iandchasse/silkscreen-light-attachment/design/visor-reflector-study.md

# Visor reflector study (2026-10-20)

Model: `tools/visor_reflector_sim.py` (geometry only; Lambertian 120 deg LEDs at y 115.9 / z 9.5, both strings lit). Mirror = specular strip on the visor inner face, R 0.85 (aluminium / mirror tape); white print = Lambertian R 0.80. "flare" = the visor face leans outward (bottom edge further from the case), like a lampshade. Numbers are page light relative to today's mid-page.

```

=== PLAIN page (z 3.926); numbers are page light relative to TODAY's mid-page ===
case                                       d2    d10    d20    mid    d70    bot | top2-20 btmhalf top/btm
bare LEDs (today)                        0.00  12.18   4.90   1.00   0.38   0.19 |   11.60    0.46    25.4
mirror R0.85 to y113.0 tilt 0           26.49  12.18   4.90   1.00   0.38   0.19 |   17.70    0.46    38.8
mirror R0.85 to y113.0 tilt 10          18.51  12.18   4.90   1.00   0.38   0.19 |   11.60    0.46    25.4
mirror R0.85 to y113.0 tilt 20           0.00  12.18   4.90   1.00   0.38   0.19 |   11.60    0.46    25.4
mirror R0.85 to y111.0 tilt 0           26.49  25.81   4.90   1.00   0.38   0.19 |   24.30    0.46    53.2
mirror R0.85 to y111.0 tilt 10          35.33  12.18   4.90   1.00   0.38   0.19 |   20.43    0.46    44.7
mirror R0.85 to y111.0 tilt 20          40.33  12.18   4.90   1.00   0.38   0.19 |   15.57    0.46    34.1
mirror R0.85 to y109.5 tilt 0           26.49  25.81  11.06   1.00   0.38   0.19 |   25.45    0.46    55.7
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
