iandchasse/silkscreen-light-attachment/pcb/docs/design_summary.md

# As-built design summary (generated by tools/report_design.py; do not edit)

Project silkscreen-light-attachment rev B, 2026-09-25. Frames: KiCad K (x_K = X + 100, y_K = 100 - Z) and enclosure E (X, Z; Y up the device). All parts on F.Cu (faces -Y, toward the case).

Board outline bbox (K): x 97.475..162.525, y 88.975..106.025; thickness 1.000 mm; 2 copper layers.

## String voltage sanity

- N = 5 LEDs per string, Rs = 200 R (CRCW0805200RFKEAHP), no series diode (rev B).
- N x Vf at 13.3 mA: 13.00 / 14.25 / 15.75 V (min / typ / max, 25 C); 16.27 V max at -10 C.
- Rs drop 2.66 V at 13.3 mA (2.79 V at 13.96 mA); Rs dissipation 39 mW.
- LED_SW (V_OUT, incl. R37 sense + FET; no diode): 16.01 V min hot, 17.26 V typ, **19.41 V worst (cold, max bin)** vs the 22.0 V ceiling (margin 2.59 V) and OVP min 24.25 V (margin 4.84 V).
- Hold-off at ~14 uA hot: 11.5 V > 6.5 V (boost body-diode rule).
- LED_MONIT lit 1.71..2.08 V; open 2.60..2.73 V (separated).
- Hot-plug peak (C9 at OVP, loop 243.5 R incl. Rs 200 R; typ..min LED bin): TPS923610 (25.5 V) 47.0-52.6 mA, TPS923611 (31.4 V) 71.3-76.8 mA, both < IFP 80 mA (IFP is rated at 0.1 ms, 1/10 duty; this pulse lasts ~0.25-1 ms, so the margin is an estimate) (gate). TPS923611 LED_SW-to-GND misinsertion ~83 mA until the OVP latch. Rs peak power in the worst pulse 1.18 W for ~1 ms (pulse-proof CRCW-HP 0805).
- Verdict: PASS.

## Parts and sourcing

- Rs choice: CRCW0805200RFKEAHP (LCSC C5972814, JLC Extended): pulse-proof 0805, kept from rev A; no JLC Basic 200 R with a documented ~1 W / 1 ms pulse rating was substituted (checked 2026-09-25 (JLC parts API, JLC Extended)). DigiKey 541-CRCW0805200RFKEAHPCT-ND (DigiKey search page for the MPN, 2026-09-25).
- J1 Hong Cheng HC-PZ254-11.5L-1x2PZ (LCSC C27985187, JLC Extended (no Basic 2.54 mm headers are listed; checked 2026-09-25); stock 24852 on 2026-09-25), pads J6 5/6: **hand-soldered by the builder**, in bom.csv, not in jlc_bom.csv / jlc_cpl.csv (12 SMT parts). DigiKey alternative: Harwin M20-9990246 (DigiKey product 3728226) - 6.1 mm post.
- J2 Hong Cheng HC-PZ254-11.5L-1x1PZ (LCSC C27985186, JLC Extended (no Basic 2.54 mm headers are listed; checked 2026-09-25); stock 10775 on 2026-09-25), pads J6 11: **hand-soldered by the builder**, in bom.csv, not in jlc_bom.csv / jlc_cpl.csv (12 SMT parts). DigiKey alternative: 1 pin cut from Harwin M20-9990246 (DigiKey product 3728226).
- Header numbers: body 2.5 / post 6.0 / tail 3.0 / pin 0.64 sq. Source: LCSC/JLC product attributes 2026-09-25 (insulation height 2.5 mm, mating pin 6 mm, end pin 3 mm, square pin, brass, gold); total 11.5 mm from the MPN; 0.64 mm square pin assumed (not listed). Alternative: Harwin M20-9990246 (DigiKey product 3728226): 1x2, 3 mm tail, 6.1 mm mating (tin); 0.1 mm deeper.
- Post tips at Y 108.10 (underside 116.60 - body 2.5 - post 6.0); J6 face Y 112.82..113.15 -> engagement 4.72..5.05 mm (limits 3.7..6.0). Tails end at Y 119.60 (2.00 above the PCB top).
- LEDs: MPN shared by every CCT; warm = C210340 (3000 K), cool = C210343 (6000 K). DigiKey: n/a - LCSC only (C210340 warm / C210343 cool).
- CPL rotation offsets (EasyEDA footprints, docs/sources/ee_*.json): LED C210340 +0 (pad 1 at -x in both), R 0805 +0 (non-polar). See docs/jlc-notes.md.

## Deviations / notes (DESIGN-SPEC-revB)

- STEP frame: kicad-cli 9.0.6 writes the bare dielectric slab (0.91) at z_s 0..0.91 and seats F-side models on the component plane z_F (~0.995). make_outputs calibrates z_F on the J1 body box and maps Y = 116.60 - (z_s - z_F), X = x_s - 100, Z = 100 + y_s (+90 deg about X, det +1). Header tips are asserted at the geometry.json values; the slab in the E-frame STEP is ~0.09 thinner than 1.0 (copper + mask not modelled). Use build/geometry.json for fit.
- LED silk cathode mark = two short bars along the long sides over pad 1 (a bar across the end would sit in the 0.43 gap of a warm/cool pair). LED courtyard = pads + 0.195 so the 3.8 mm pair pitch leaves 0.04.
- Header courtyards = the modelled bodies (2.50 wide per row), so J1 and J2 sit 0.04 apart; the F-side silk is one L-shaped outline around both bodies drawn on the board, not in the footprints.
- Part keep-outs (case top except the J6 opening, LED band, R zone, boss holes +0.4) are enforced by tools/check_handedness.py (courtyard boxes), not by KiCad rule areas.
- Header pin section 0.64 square and body width 2.50 are assumed (standard for the HC-PZ254 style; the LCSC page lists body 2.5 / post 6 / tail 3 but no drawing numbers were readable).
- Fab outputs (Gerber X2 dates, STEP, PDFs) carry timestamps; the generated KiCad sources are deterministic.

## Footprints

| Ref | Value | Footprint | x_K | y_K | rot | X (E) | Z (E) | pads (num: net) |
|---|---|---|---|---|---|---|---|---|
| D1 | HL-A-3014H421W-S1-08HL-HR3 | LED_3014_HONGLI_HL-A-3014H421W | 101.100 | 90.500 | 180 | 1.100 | 9.500 | 1: /W_K1, 2: /LED_SW |
| D2 | HL-A-3014H421W-S1-08HL-HR3 | LED_3014_HONGLI_HL-A-3014H421W | 114.600 | 90.500 | 180 | 14.600 | 9.500 | 1: /W_K2, 2: /W_K1 |
| D3 | HL-A-3014H421W-S1-08HL-HR3 | LED_3014_HONGLI_HL-A-3014H421W | 128.100 | 90.500 | 180 | 28.100 | 9.500 | 1: /W_K3, 2: /W_K2 |
| D4 | HL-A-3014H421W-S1-08HL-HR3 | LED_3014_HONGLI_HL-A-3014H421W | 141.600 | 90.500 | 180 | 41.600 | 9.500 | 1: /W_K4, 2: /W_K3 |
| D5 | HL-A-3014H421W-S1-08HL-HR3 | LED_3014_HONGLI_HL-A-3014H421W | 155.100 | 90.500 | 180 | 55.100 | 9.500 | 1: /W_R, 2: /W_K4 |
| D6 | HL-A-3014H421W-S1-08HL-HR3 | LED_3014_HONGLI_HL-A-3014H421W | 104.900 | 90.500 | 180 | 4.900 | 9.500 | 1: /C_K1, 2: /LED_SW |
| D7 | HL-A-3014H421W-S1-08HL-HR3 | LED_3014_HONGLI_HL-A-3014H421W | 118.400 | 90.500 | 180 | 18.400 | 9.500 | 1: /C_K2, 2: /C_K1 |
| D8 | HL-A-3014H421W-S1-08HL-HR3 | LED_3014_HONGLI_HL-A-3014H421W | 131.900 | 90.500 | 180 | 31.900 | 9.500 | 1: /C_K3, 2: /C_K2 |
| D9 | HL-A-3014H421W-S1-08HL-HR3 | LED_3014_HONGLI_HL-A-3014H421W | 145.400 | 90.500 | 180 | 45.400 | 9.500 | 1: /C_K4, 2: /C_K3 |
| D10 | HL-A-3014H421W-S1-08HL-HR3 | LED_3014_HONGLI_HL-A-3014H421W | 158.900 | 90.500 | 180 | 58.900 | 9.500 | 1: /C_R, 2: /C_K4 |
| H1 | M1 housing boss (dia 4.40) + ST2.2 screw | NPTH_4.80mm | 110.000 | 101.000 | 0 | 10.000 | -1.000 | npth: - |
| H2 | M2 housing boss (dia 4.40) + ST2.2 screw | NPTH_4.80mm | 138.000 | 101.000 | 0 | 38.000 | -1.000 | npth: - |
| J1 | HC-PZ254-11.5L-1x2PZ | J6_PLUG_1x2_P5_P6 | 155.932 | 103.810 | 0 | 55.932 | -3.810 | 5: /LED_SW, 6: /W- |
| J2 | HC-PZ254-11.5L-1x1PZ | J6_PLUG_1x1_P11 | 154.662 | 101.270 | 0 | 54.662 | -1.270 | 11: /C- |
| R1 | CRCW0805200RFKEAHP | R_0805_2012Metric | 145.500 | 103.600 | 0 | 45.500 | -3.600 | 1: /W_R, 2: /W- |
| R2 | CRCW0805200RFKEAHP | R_0805_2012Metric | 149.000 | 101.400 | 0 | 49.000 | -1.400 | 1: /C_R, 2: /C- |

## Copper by net

| Net | F.Cu mm | B.Cu mm | widths | vias |
|---|---|---|---|---|
| /C- | 4.8 | 0.0 | [0.4] | [] |
| /C_K1 | 13.2 | 0.0 | [0.25] | [] |
| /C_K2 | 13.2 | 0.0 | [0.25] | [] |
| /C_K3 | 13.2 | 0.0 | [0.25] | [] |
| /C_K4 | 13.2 | 0.0 | [0.25] | [] |
| /C_R | 21.8 | 0.0 | [0.4] | [] |
| /LED_SW | 7.5 | 64.3 | [0.25, 0.4] | [(99.87, 92.6)] |
| /W- | 13.5 | 0.0 | [0.4] | [] |
| /W_K1 | 13.8 | 0.0 | [0.25] | [] |
| /W_K2 | 13.8 | 0.0 | [0.25] | [] |
| /W_K3 | 13.8 | 0.0 | [0.25] | [] |
| /W_K4 | 13.8 | 0.0 | [0.25] | [] |
| /W_R | 23.7 | 0.0 | [0.4] | [] |

## Handedness / placement gate (tools/check_handedness.py)

- PASS exactly 3 plated through-holes, all on J1/J2 (found 3)
- PASS pad '5' on J1 (want J1)
- PASS J1 '5' at E (54.662, -3.810) vs J6-5 (54.662, -3.810): 0.0000 <= 0.02
- PASS J1 '5' via the STEP chain: E (54.662, Y 116.60, -3.810) agrees
- PASS J1 '5' net LED_SW == J6-5 LED_SW
- PASS pad '6' on J1 (want J1)
- PASS J1 '6' at E (57.202, -3.810) vs J6-6 (57.202, -3.810): 0.0000 <= 0.02
- PASS J1 '6' via the STEP chain: E (57.202, Y 116.60, -3.810) agrees
- PASS J1 '6' net W- == J6-6 W-
- PASS pad '11' on J2 (want J2)
- PASS J2 '11' at E (54.662, -1.270) vs J6-11 (54.662, -1.270): 0.0000 <= 0.02
- PASS J2 '11' via the STEP chain: E (54.662, Y 116.60, -1.270) agrees
- PASS J2 '11' net C- == J6-11 C-
- PASS STEP->E rotation determinant 1 (proper rotation)
- PASS J6-12 P+_FUSE at E (57.202, -1.27): nearest copper 1.690, nearest hole 2.030 (>= 1.0)
- PASS J6-4 GND at E (52.122, -3.81): nearest copper 1.390, nearest hole 2.030 (>= 1.0)
- PASS 2 NPTH holes (params: 2)
- PASS NPTH M1 dia 4.8 at E (10.0, -1.0)
- PASS NPTH M2 dia 4.8 at E (38.0, -1.0)
- PASS copper to NPTH edge min 3.965 >= 0.4
- PASS tracks to NPTH edge min 3.988 >= 0.5
- PASS D1 on F.Cu
- PASS D1 courtyard E x -0.78..2.98 z 8.55..10.45: clear of keep-outs
- PASS R1 on F.Cu
- PASS R1 courtyard E x 43.82..47.18 z -4.55..-2.65: clear of keep-outs
- PASS R2 on F.Cu
- PASS R2 courtyard E x 47.32..50.68 z -2.35..-0.45: clear of keep-outs
- PASS D6 on F.Cu
- PASS D6 courtyard E x 3.02..6.78 z 8.55..10.45: clear of keep-outs
- PASS D5 on F.Cu
- PASS D5 courtyard E x 53.22..56.98 z 8.55..10.45: clear of keep-outs
- PASS D4 on F.Cu
- PASS D4 courtyard E x 39.72..43.48 z 8.55..10.45: clear of keep-outs
- PASS D8 on F.Cu
- PASS D8 courtyard E x 30.02..33.78 z 8.55..10.45: clear of keep-outs
- PASS D10 on F.Cu
- PASS D10 courtyard E x 57.02..60.78 z 8.55..10.45: clear of keep-outs
- PASS J1 on F.Cu
- PASS J1 courtyard E x 53.39..58.47 z -5.06..-2.56: clear of keep-outs
- PASS D9 on F.Cu
- PASS D9 courtyard E x 43.52..47.28 z 8.55..10.45: clear of keep-outs
- PASS D2 on F.Cu
- PASS D2 courtyard E x 12.72..16.48 z 8.55..10.45: clear of keep-outs
- PASS J2 on F.Cu
- PASS J2 courtyard E x 53.39..55.93 z -2.52..-0.02: clear of keep-outs
- PASS D7 on F.Cu
- PASS D7 courtyard E x 16.52..20.28 z 8.55..10.45: clear of keep-outs
- PASS D3 on F.Cu
- PASS D3 courtyard E x 26.22..29.98 z 8.55..10.45: clear of keep-outs
- PASS NPTH M1 dia 4.8 at E (10.0, -1.0): web to board edge 2.600 >= 0.5
- PASS NPTH M2 dia 4.8 at E (38.0, -1.0): web to board edge 2.600 >= 0.5
- INFO outline 8 Edge.Cuts primitives; min NPTH web 2.600 (M1)
- PASS silk: 33 strokes, min width 0.150 >= 0.15
- PASS silk: 8 visible texts, min height 1.000, min stroke 0.150; W/C markers at >= 1.0
