iandchasse/silkscreen-light-attachment/design/superseded/README.md

# Superseded

Partial architecture proposals from 2026-09-25 written while the scope still included an in-case (integrated bezel) variant. The runs were stopped when the scope changed to the external clip-on only. Kept for history; do not use.
