iandchasse/silkscreen-light-attachment/design/superseded/proposal-A-one-pcba.md

# Proposal A - one PCBA for both variants (architect)

Status: IN PROGRESS (skeleton written first; sections fill in as the analysis lands). 2026-09-25.

## 0. Decision summary
(pending)

## 1. PCBA
(pending)

## 2. Header safety
(pending)

## 3. External clip-on housing
(pending)

## 4. Integrated variant (modified enclosure copy)
(pending)

## 5. Risks, open questions, build plan
(pending)
