iandchasse/silkscreen-light-attachment/design/superseded/proposal-B-best-light.md

# Proposal B: best light (architect)

Status: IN PROGRESS (skeleton, 2026-09-25). Frame: enclosure frame (X = KiCad X - 44.24, Y = 148.25 - KiCad Y, Z = 0 at
main-PCB rear, +Z toward the viewer).

## 0. Decision summary
(pending)

## 1. PCBA
(pending)

## 2. Header safety
(pending)

## 3. External clip-on housing
(pending)

## 4. Integrated variant
(pending)

## 5. Risks, open questions, build plan
(pending)
