iandchasse/silkscreen-light-attachment/archive/rev-A-rod-lens/housing/out/REPORT.md

# Housing build report (rev A)

Generated by `housing/src/build.py` (deterministic, E frame). PCBA for the fit checks: pcb/build/geometry.json (pcb/tools/export_geometry.py, 2026-09-25); used from file: outline (102 pts), 9 NPTH holes, 15 body boxes, 3 header pins.

| Check | Result | Key numbers |
|---|---|---|
| 1. Seated vs stock case | PASS | back bumps 0.3/0.3, leaf bump 0.4; corner fingers gap 0.096/0.096; boss 0.315 |
| 2. Insertion sweep h 15 -> 0 | PASS | 0 undesigned collisions; X guided from h 7.31, Z from h 10.266, pins touch J6 at h 5.42 |
| 3. Pins vs J6 | PASS | tips [107.94]; E 4.68..5.21; wall clearance 1.165 nominal / 1.115 centred |
| 4. Optics keep-out | PASS | intrusion {'clip': 0.0, 'cover': 0.0, 'carrier': 0.0}; clip gap with float 0.1 |
| 5. PCBA/carrier at float extremes | PASS | carrier/rod min 0.443; PCBA min 0.4 (>= 0.40, designed contacts excluded) |
| 5b. PCB agent's E-frame PCBA STL (cross-check) | OK | y 107.94..121.4; part bodies to clip 0.7, to cover 0.696 (seated nominal) |
| 6. Printability | PASS | overhang patches flagged {'clip': 0, 'cover': 15, 'carrier': 16}, all bridge-width; undeclared min wall {'clip': 1.015, 'cover': 1.0, 'carrier': 1.0} |
| 7. Exports | PASS | 13 files |
| 8. Rod datum (rev A) | PASS | rod axis preloaded y 113.91, z [15.8, 15.8] (target 113.91 / 15.80 +-0.05); LED gap 2.0; lip interference [0.16]; snap chord 3.6 |
| 9. Tongue-bump lead-in (rev A) | PASS | full crest from y [119.55]; bump bottom [-0.35] vs the PCB edge; overlap at landing 0.0 mm3 |
| Screws (rev A) | PASS | ST2.2 x 6.5 pan, plastics thread-forming (DIN 7981 form / PT class); tip 115.9, above the case {'C0': 0.3, 'C1': 0.3, 'C2': 0.3}; engaged {'C0': 2.5, 'C1': 2.5, 'C2': 2.4}; walls {'C2 pilot to the header-notch face x 59.20': 0.8, 'C2 after thread forming (major 2.2)': 0.6, 'C1 pilot in the P3 pad layer (z)': [0.75, 0.85], 'cover column wall': 0.55, 'screw radial clearance in the column bore': 0.15} |

**Overall: PASS**

## Rod datum and retention (check 8, rev A)

```
{
 "rod_axis_preloaded": {
  "y": 113.91,
  "z": [
   15.8,
   15.8
  ]
 },
 "lips": {
  "lip_L_mz": {
   "interference": 0.16,
   "contact_deg_below_equator": 11.3,
   "x": [
    -2.8,
    -1.4
   ]
  },
  "lip_L_pz": {
   "interference": 0.16,
   "contact_deg_below_equator": 11.3,
   "x": [
    -2.8,
    -1.4
   ]
  },
  "lip_R_mz": {
   "interference": 0.16,
   "contact_deg_below_equator": 11.3,
   "x": [
    61.4,
    62.8
   ]
  },
  "lip_R_pz": {
   "interference": 0.16,
   "contact_deg_below_equator": 11.3,
   "x": [
    61.4,
    62.8
   ]
  }
 },
 "led_face_y_min": 117.91,
 "gap_led_to_rod": 2.0,
 "cradle": {
  "bore_d": 4.15,
  "bore_centre_y": 113.835,
  "crown_y": 115.91,
  "rod_axis_on_crown_y": 113.91,
  "lip": {
   "t": 0.8,
   "slot": 0.4,
   "root_deg_above_equator": 56.0,
   "hook_deg_below_equator": [
    4.0,
    12.0
   ],
   "hook_radius_about_axis": 1.84,
   "interference_radial": 0.16,
   "x_length": 1.4,
   "tip_deg": 22.0,
   "tip_chord": 4.1
  },
  "snap_chord_at_hook": 3.6,
  "snap_deflection_each_lip": 0.2,
  "radial_play_at_equator": 0.075,
  "axial_play_each_end": 0.2,
  "end_wall_behind_socket": 1.0,
  "dowel": {
   "d": 1.5,
   "L": 4.0,
   "hole_d": 1.55,
   "hole_depth": 2.4
  },
  "dowel_hole_floor_over_crown": 0.3
 }
}
```

## Engagement order (as built, h above seated)

| h | event |
|---|---|
| 10.266 | back_finger_R engages (gap <= 0.2) |
| 10.265 | back_finger_L engages (gap <= 0.2) |
| 9.63 | corner_finger_L.front(Z) engages (gap <= 0.15) |
| 9.63 | corner_finger_R.front(Z) engages (gap <= 0.15) |
| 8.726 | clip.back_bump_R starts riding the case (preload builds) |
| 8.725 | clip.back_bump_L starts riding the case (preload builds) |
| 8.213 | clip.back_bump_L reaches full preload (on the flat face) |
| 8.213 | clip.back_bump_R reaches full preload (on the flat face) |
| 8.099 | clip.leaf_bump starts riding the case (preload builds) |
| 7.87 | pin tips (hanging, 107.73) cross the top-face plane |
| 7.662 | leaf engages (gap <= 0.2) |
| 7.31 | corner_finger_L.side(X) engages (gap <= 0.15) |
| 7.31 | corner_finger_R.side(X) engages (gap <= 0.15) |
| 6.913 | clip.leaf_bump reaches full preload (on the flat face) |
| 5.42 | pin tips reach the J6 face y 113.15 (enclosure model) |
| 5.2 | pin tips reach the J6 face y 112.93 (B.Fab) |
| 5.09 | pin tips reach the J6 face y 112.82 (STEP-internal) |
| 4.89 | pin tips reach the J6 face y 112.62 (STEP, main board 0.20 down (INFERRED)) |
| 3.599 | lip engages (gap <= 0.02) |
| 3.235 | ear engages (gap <= 0.02) |
| 1.4 | J6 boss enters the opening |
| 0.02 | P1 engages (gap <= 0.02) |
| 0.02 | P2 engages (gap <= 0.02) |
| 0.02 | P3 engages (gap <= 0.02) |
| 0.0 | P1/P2/P3 land on the top face; tips at y 107.94 |

M-spec 3c / audit m1 for comparison: pins cross top face 7.65 (M-spec) / 7.87 (audit m1); pins reach J6 5.21..4.68 (M-spec) / 5.42..4.89 (audit m1); X guided 7.6; Z guided 10.8/10.6 (audit: fingers 10.1..7.6, back 10.6); right ear 3.6; lip 3.8; boss 1.4; left leaf 6.1.

## Seated gaps to the stock case, every clip feature (check 1)

| feature | kind | gap | interference mm3 | depth |
|---|---|---|---|---|
| back_rail | clearance | 0.4 | 0.0 |  |
| front_rail | clearance | 0.4 | 0.0 |  |
| left_block | clearance | 0.4 | 0.0 |  |
| right_block | clearance | 0.403 | 0.0 |  |
| P1 | datum contact | 0.0 | 0.0 |  |
| P1_block | clearance | 0.4 | 0.0 |  |
| P2 | datum contact | 0.0 | 0.0 |  |
| P2_block | clearance | 0.4 | 0.0 |  |
| P3 | datum contact | 0.0 | 0.0 |  |
| P3_block | clearance | 0.4 | 0.0 |  |
| boss_bridge | clearance | 0.4 | 0.0 |  |
| boss | clearance | 0.315 | 0.0 |  |
| lip | datum contact | 0.0 | 0.0 |  |
| back_finger_L | clearance | 0.15 | 0.0 |  |
| back_bump_L | spring bump (designed interference) | 0.0 | 1.219 | 0.3 |
| back_finger_R | clearance | 0.15 | 0.0 |  |
| back_bump_R | spring bump (designed interference) | 0.0 | 1.219 | 0.3 |
| leaf | clearance | 0.15 | 0.0 |  |
| leaf_bump | spring bump (designed interference) | 0.0 | 0.9699 | 0.4 |
| corner_finger_L | clearance | 0.096 | 0.0 |  |
| corner_finger_R | clearance | 0.096 | 0.0 |  |
| ear | datum contact | 0.0 | 0.0 |  |

Cover, carrier, rod and PCBA minimum gap to the case: 0.517 (pcba.J1_body; the pins sit in the J6 opening).

## Engagement stack (measured from the solids)

pad face 115.6 -> clip top 118.4 (+2.8) -> tail pad 121.4 (+3.001) -> tip 107.94 (off the case 107.73); PCB underside 118.61.

Engagement nominal {'enclosure model': 5.21, 'B.Fab': 4.99, 'STEP-internal': 4.88, 'STEP, main board 0.20 down (INFERRED)': 4.68}; worst [4.03, 5.64] (limits 3.68/6.0, margins [0.35, 0.36]). M-spec 2d: tip 107.94; E 4.68..5.21 nominal, 4.03..5.64 worst (limits 3.68/6.00).

## Springs (PETG E 2.0 GPa)

| spring | L | b | t | deflection | k N/mm | force N | strain % | M-spec / audit |
|---|---|---|---|---|---|---|---|---|
| back_finger (each) | 10.0 | 7.6 | 1.4->1.0 | 0.3 (0.05..0.55) | 8.69 | 2.61 (0.43..4.78) | 0.52 / 0.96 | rev 0: t 1.2, b 10, k 8.64 N/mm, 2.59 N, strain 0.54 / 0.99 %, root stress 10.8 MPa |
| left_leaf | 11.5 | 3.8 | 1.4->1.0 | 0.4 (0.15..0.65) | 2.77 | 1.11 (0.42..1.8) | 0.51 / 0.83 | rev 0: t 1.2, b 5.0, k 2.84 N/mm, 1.14 N, strain 0.54 / 0.88 %, root stress 10.9 MPa |
| cradle_lip (each of 4) | 2.76 | 1.4 | 0.8 | 0.162 (0.151..0.2) | 16.96 | 2.74 (2.54..3.39) | 2.54 / 3.14 | curved lip, straight-cantilever estimate over the arc length; max strain is the snap-through (0.2 per lip, chord 3.6); one-time assembly, then epoxy dots |
| tongue_left | 7.25 | 4.35 | 0.8 | 0.15 / 0.45 | 2.92 | 0.438 / 1.315 | 1.03 | k ~0.75 N/mm, 0.11 N preload, 0.34 N full float (1.5-tall floating tongue) |
| tongue_right | 7.25 | 4.35 | 0.8 | 0.15 / 0.45 | 2.92 | 0.438 / 1.315 | 1.03 | k ~0.75 N/mm, 0.11 N preload, 0.34 N full float (1.5-tall floating tongue) |
| tongue_back | 7.25 | 4.35 | 0.8 | 0.15 / 0.45 | 2.92 | 0.438 / 1.315 | 1.03 | k ~0.75 N/mm, 0.11 N preload, 0.34 N full float (1.5-tall floating tongue) |
| tongue_front | 7.25 | 4.35 | 0.8 | 0.15 / 0.45 | 2.92 | 0.438 / 1.315 | 1.03 | k ~0.75 N/mm, 0.11 N preload, 0.34 N full float (1.5-tall floating tongue) |

Retention about 7.97 N (J6 4.17 + friction 3.8); insertion about 8.81 N. retention ~8 N (5..12), insertion ~10 N.

## Deviations from DESIGN-SPEC

1. Centering tongues: full-height flexures (y 119.05..123.40, cut through the roof with U-slits) instead of 1.5-tall tongues floating mid-wall centred on y 119.4. A mid-wall horizontal cantilever is an 8 mm unsupported overhang when the cover prints roof-down. As built k = 2.92 N/mm (audit 0.75): 0.44 N at the 0.15 preload and 1.32 N at full float. Three pins give about 26 N/mm laterally, so they bend about 0.05 mm. Contact band y 119.05..121.60 covers the PCB edge both seated (118.61..120.21) and resting (118.40..120.00).
2. Tongue face set 0.45 behind the PCB edge with a 0.60 bump (0.15 preload), so the rigid tongue root never touches the PCB at full float (0.15 clear). The contract says "0.15 bump"; read here as the 0.15 preload. The tongue bottom is at 119.05, not 118.65, so the front tongue keeps 0.44 from the seated carrier flange (>= 0.40).
3. Rod-carrier pins: printed pins cannot exist on a part printed flanges-down, because they would point into the bed. The two datum pins are steel dowels, Ø1.5 x 4 (ISO 8734, a stocked length), set in 5-minute epoxy in Ø1.55 x 2.4 slip holes, so they sit flush with the PCB top (no stake heads, roof clearance 1.39). Rev A: was Ø1.5 x 3 pressed into Ø1.45 x 1.5 (review MINOR-5: 7 % hoop strain in a 0.675 wall). The hole floor over the cradle crown is 0.30 (declared). The 4 stake holes are adhesive points: epoxy through the Ø1.6 PCB holes onto the flanges, now at z 13.10 / 18.30, with 0.3 x 0.3 glue-dam rebates along both flange inner edges. Heat-staking is dropped.
4. C-cradle mouth faces -Y (away from the PCB), not +Y. The datum hole (-2.40, 16.00) sits directly above the rod end (x -3.0..-1.0), so the material above the rod must be solid to carry the dowel. Rev A (review MAJOR-1): the rod datums on the bore crown. Bore Ø4.15 centred at y 113.835, so the crown (115.91) puts the rod axis at 113.91, 2.00 below the LED faces. Below the equator each side is a curved lip flexure, 0.8 thick, rooted 56 deg above the equator behind a 0.4 slot, free 0.4 from both socket faces (1.4 long in x). Its hook (radius 1.84 about the rod axis, 4..12 deg below the equator) gives 0.16 interference and preloads the rod up onto the crown in any orientation. Snap-through 0.20 per lip (chord 3.60). The end walls widen to z 12.00..19.60 to make room (0.45 from the cover at full float).
5. Socket depth 2.2 (contract 2.0): 0.20 axial play per end for a hand-cut 66.0 rod, and the end wall behind the socket stays 1.0. Rod-end faces stay at x -3.0 / 63.0 nominal.
6. Contract-forced thin walls, declared: the C1 pilot (Ø1.8) inside the 0.4-tall P3 pad leaves 0.75 / 0.85 (C1 at z 2.35, P3 z 0.7..4.1). The C2 pilot (x 60.90) leaves 0.80 to the header-notch face, moved 59.3 -> 59.2 (J1 body keeps 0.43 at full float). The dowel hole (Ø1.55) at x -2.40 leaves 0.625 to the end-wall inner face and a 0.30 floor over the cradle crown. The cradle lips are 0.8, the outer strip beside each slot 0.525. The glue-dam rebates leave 0.7 of the 1.0 flange. The engraved-text ribs are cosmetic, in the top 0.4 of a 1.8 roof.
7. P3 pad z0 0.6 -> 0.7 and back-rail notch z -5.70 -> -5.80. The header body keeps 0.40 from the clip at full float (M-spec gave 0.30 / 0.32).
8. Left leaf b 6.0 (z -2.5..3.5) -> 5.0 (z -3.0..2.0), and the left corner-finger side part z 2.0 -> 2.5..4.2. The M-spec leaf and finger side part overlap at z 2.0..3.5 on the same x; they are now 0.5 apart. Leaf k 2.84 N/mm, 1.14 N at 0.40 (M-spec 3.4 / 1.4). Rev A MINOR-7 narrowed it again to b 3.8 (z -2.4..1.4) with the 1.4 -> 1.0 taper.
9. Roof underside 121.60 (1.8 roof). The tail pad is 0.20 proud at 121.40 (the stack datum) over x 52.9..59.0, z -5.6..0.5. Column bosses Ø5.2 run down to y 120.66 (0.45 above the seated PCB top) under the Ø4.4 x 1.0 counterbores. The contract columns are Ø3.6; rev A opens the bore 2.3 -> 2.5 (review MAJOR-3), so the wall is 0.55, declared thin (100 % infill, drill 2.4 through). Screws: ST2.2 x 6.5 pan, DIN 7981 form / PT-class plastics thread-former; head seat 122.40, tip 115.90 (0.30 above the case top), 2.5 engaged at C0/C1 and 2.4 at C2.
10. Cover walls sit 0.75 off the PCB edges (0.45 at full float), and the back-region walls are 2.0 thick so 1.0 remains behind the tongue slots. Skirt inner face at z 20.35 (contract >= 20.30), 2.0 thick. The front-region end walls sit at x -4.95 / 64.95. Rev A (review MAJOR-4): 3 grip ribs on each end face (x -6.25 / 66.25, z -6.5..1.5, centred over the posts, 0.5 proud, flat underside + 45-deg top flank) and a 0.6-deep fingernail ledge in the back wall (y 120.4..121.4, x 3..18 and 30..57). Envelope x -6.75..66.75, y 103.0..123.40, z -8.95..22.35 (M-spec -8.05..21.0).
11. Clip pilots Ø1.8 (rev A, was 1.6) are through holes. Blind holes would leave 0.4-0.8 floors under P1/P3, below the 1.0 minimum wall.
12. Corner fingers are 1.5 thick (M-spec 1.6; its printability table allows 1.5-1.6). Rev A: the back-finger and leaf bump crests are R0.3 rounds whose top keeps the 0.30 / 0.40 interference exact; the lip bottom inner edge is R0.5 (was a 0.3 chamfer); the back fingers and leaf taper 1.4 -> 1.0 with R1.5 root fillets, narrowed to b 7.6 / 3.8 so k stays at 8.7 / 2.8 N/mm; the back-rail outer face moves -8.05 -> -8.25 to meet the 1.4 finger roots. The tongue bumps get a 45-deg 0.50 lead-in (full crest from 119.55). The orientation arrow and "SCREEN" are engraved 0.4 deep, because the roof top is the print bed. The 0.2 elephant-foot chamfers are left to the slicer.

## Outputs

- `out/print/{clip,cover,carrier}.{stl,step}`: print orientation, bed at Z 0.
- `out/print/housing-plate.3mf`: one plate with all three parts.
- `out/E/*.stl`, `out/E/assembly_E.step`: E-frame references (PCB seated).
- `out/render/*.png`: assembly on the case (iso front/back), front view, section at x 55.9 (J6), section at x 30 (rod), section at x -2.1 (left cradle lips).
- `out/checks.json`: every number behind this report.

## OrcaSlicer

```
{
 "presets": {
  "machine": "Elegoo Centauri Carbon 2 0.4 nozzle",
  "process": "0.20mm Standard @Elegoo CC2 0.4 nozzle",
  "filament": "Elegoo PETG @ECC2"
 },
 "overrides": {
  "process": {
   "wall_loops": "3",
   "sparse_infill_density": "30%",
   "enable_support": "0"
  }
 },
 "clip": {
  "exit": 0,
  "gcode": "plate_1.gcode",
  "warnings": [],
  "time": "21m 3s",
  "grams": "3.95",
  "layers": "77",
  "filament_type": "PETG",
  "support_used": "0"
 },
 "cover": {
  "exit": 0,
  "gcode": "plate_1.gcode",
  "warnings": [],
  "time": "24m 24s",
  "grams": "7.98",
  "layers": "67",
  "filament_type": "PETG",
  "support_used": "0"
 },
 "carrier": {
  "exit": 0,
  "gcode": "plate_1.gcode",
  "warnings": [],
  "time": "10m 22s",
  "grams": "1.97",
  "layers": "43",
  "filament_type": "PETG",
  "support_used": "0"
 }
}
```
