iandchasse/silkscreen-light-attachment/archive/rev-A-rod-lens/pcb/docs/design_summary.md

# As-built design summary (generated by tools/report_design.py; do not edit)

Project silkscreen-light-attachment rev A, 2026-09-25. Frames: KiCad K (x_K = X + 100, y_K = 100 - Z) and enclosure E (X, Z; Y up the device). All parts on F.Cu (faces -Y, toward the case).

Board outline bbox (K): x 95.775..164.225, y 80.375..106.225; thickness 1.600 mm; 2 copper layers.

## String voltage sanity

- N = 5 LEDs per string, Rs = 200 R (CRCW0805200RFKEAHP), BAW56 series diode.
- N x Vf at 13.3 mA: 13.00 / 14.25 / 15.75 V (min / typ / max, 25 C); 16.27 V max at -10 C.
- Rs drop 2.66 V at 13.3 mA (2.79 V at 13.96 mA); Rs dissipation 39 mW.
- LED_SW (V_OUT, incl. BAW56 + R37 sense + FET): 16.61 V min hot, 17.98 V typ, **20.36 V worst (cold, max bin)** vs the 22.0 V ceiling (margin 1.64 V) and OVP min 24.25 V (margin 3.89 V).
- Hold-off at ~14 uA hot: 11.5 V > 6.5 V (boost body-diode rule).
- LED_MONIT lit 1.78..2.18 V; open 2.60..2.73 V (separated).
- Hot-plug peak (C9 at OVP, loop 243.5 R incl. Rs 200 R; typ..min LED bin): TPS923610 (25.5 V) 43.7-49.3 mA, TPS923611 (31.4 V) 68.0-73.5 mA, both < IFP 80 mA (IFP is rated at 0.1 ms, 1/10 duty; this pulse lasts ~0.25-1 ms, so the margin is an estimate) (gate). TPS923611 LED_SW-to-GND misinsertion ~79 mA until the OVP latch.
- Verdict: PASS.

## Parts and sourcing

- Rs choice: CRCW0805200RFKEAHP (LCSC C5972814, JLC Extended, 2,477 in stock 2026-09-25): 200 R keeps the TPS923611 hot-plug peak under the LED IFP (review-electrical F3, DESIGN-SPEC sec 7) (checked 2026-09-25 (JLC parts API, JLC Extended)). DigiKey 541-CRCW0805200RFKEAHPCT-ND (DigiKey search page for the MPN, 2026-09-25).
- J1 TSW-102-14-G-D-004 (LCSC C20382277, out of stock 2026-09-25) is **DNP at JLC** (hand-solder; not placed by JLC): buy 612-TSW-102-14-G-D-ND (push out position 4 = J6-12). It stays in bom.csv and is left out of jlc_bom.csv / jlc_cpl.csv (14 SMT parts).
- LEDs: MPN shared by every CCT; warm = C210340 (3000 K), cool = C210343 (6000 K). DigiKey: n/a - LCSC only (C210340 warm / C210343 cool).
- CPL rotation offsets (EasyEDA footprints, docs/sources/ee_*.json): LED C210340 +0 (pad 1 at -x in both), BAW56 C8663 SOT-23 +180 (EasyEDA pads 1/2 at +x), R 0805 +0 (non-polar). See docs/jlc-notes.md.

## Deviations from DESIGN-SPEC

- Outline step fillets R0.35 (convex) + R0.35 (concave) instead of R0.5: each width step is only 0.70 (x -4.20 -> -3.50 and 63.50 -> 64.20), and two fillets on one 0.70 edge can total at most 0.70 (R0.5 + R0.5 would need 1.00; R1.0 + R0.5 would need 1.50).
- STEP frame: kicad-cli 9.0.6 does not put F.Cu at z_s = 0 / B.Cu at z_s = -1.6 (sec 1). It writes the bare dielectric slab (1.51) at z 0..1.51 and seats F-side models on the component plane z = 1.595. make_outputs calibrates that plane on the J1 body box and maps Y = 118.61 - (z_s - 1.595), X = x_s - 100, Z = 100 + y_s (still a +90 deg rotation about X, det +1). Header tips land exactly at Y 107.94 / 121.40 (asserted); the PCB slab in the E-frame STEP spans Y 118.695..120.205 (copper + mask not modelled) vs nominal 118.61..120.21. Use build/geometry.json (118.61 / 120.21) for fit checks.
- LED silk cathode mark = two short bars along the long sides over pad 1, not a bar across the end: inside a warm/cool pair the pads are only 0.43 apart. F.Fab carries K/A letters and the pin-1 body chamfer.
- LED courtyard is pads + 0.195 (not IPC 0.25) so the 3.8 mm pair pitch leaves 0.04 between courtyards.
- Part keep-outs are enforced by tools/check_handedness.py (courtyard vs keep-out rectangles, height zones), not by KiCad rule areas: the NPTH column holes are footprints that legitimately sit inside keep-outs.
- J1 DigiKey field = 612-TSW-102-14-G-D-ND (the stocked 2x2 TSW-102-14-G-D): push out position 4 (J6-12) before soldering. The -004 MPN stays in the MPN field; J1 is DNP at JLC and hand-soldered by the builder, so it is not in jlc_bom.csv / jlc_cpl.csv.
- C2 moved to X 60.90 for a 0.50 edge web: J1's body box is 0.328 from the C2 hole edge (spec: parts 0.4 off the column holes). The Ø3.60 column floats 0.30 in the Ø4.20 hole, so the body keeps >= 0.33 from the column. The gate allows 0.30 for J1 vs C2 only; the 4.2 NPTH courtyard margin is 0.30 (was 0.40) so DRC courtyard overlap stays an error.
- Cool-string links (and the D1-D6 anode bridge) moved from y_K 83.10 to 83.15 so the tracks keep 0.525 from the moved +Z stake holes (z 18.30) and 0.265 from the LED pads.
- Fab outputs (Gerber X2 creation date, kicad-cli/CadQuery STEP, PDFs) carry timestamps; the generated KiCad sources, library and models are byte-identical run to run (KIID seed + uuid rewrite + model stamp).

## Footprints

| Ref | Value | Footprint | x_K | y_K | rot | X (E) | Z (E) | pads (num: net) |
|---|---|---|---|---|---|---|---|---|
| D1 | HL-A-3014H421W-S1-08HL-HR3 | LED_3014_HONGLI_HL-A-3014H421W | 101.100 | 84.000 | 180 | 1.100 | 16.000 | 1: /W_K1, 2: /LED_SW |
| D2 | HL-A-3014H421W-S1-08HL-HR3 | LED_3014_HONGLI_HL-A-3014H421W | 114.600 | 84.000 | 180 | 14.600 | 16.000 | 1: /W_K2, 2: /W_K1 |
| D3 | HL-A-3014H421W-S1-08HL-HR3 | LED_3014_HONGLI_HL-A-3014H421W | 128.100 | 84.000 | 180 | 28.100 | 16.000 | 1: /W_K3, 2: /W_K2 |
| D4 | HL-A-3014H421W-S1-08HL-HR3 | LED_3014_HONGLI_HL-A-3014H421W | 141.600 | 84.000 | 180 | 41.600 | 16.000 | 1: /W_K4, 2: /W_K3 |
| D5 | HL-A-3014H421W-S1-08HL-HR3 | LED_3014_HONGLI_HL-A-3014H421W | 155.100 | 84.000 | 180 | 55.100 | 16.000 | 1: /W_R, 2: /W_K4 |
| D6 | HL-A-3014H421W-S1-08HL-HR3 | LED_3014_HONGLI_HL-A-3014H421W | 104.900 | 84.000 | 180 | 4.900 | 16.000 | 1: /C_K1, 2: /LED_SW |
| D7 | HL-A-3014H421W-S1-08HL-HR3 | LED_3014_HONGLI_HL-A-3014H421W | 118.400 | 84.000 | 180 | 18.400 | 16.000 | 1: /C_K2, 2: /C_K1 |
| D8 | HL-A-3014H421W-S1-08HL-HR3 | LED_3014_HONGLI_HL-A-3014H421W | 131.900 | 84.000 | 180 | 31.900 | 16.000 | 1: /C_K3, 2: /C_K2 |
| D9 | HL-A-3014H421W-S1-08HL-HR3 | LED_3014_HONGLI_HL-A-3014H421W | 145.400 | 84.000 | 180 | 45.400 | 16.000 | 1: /C_K4, 2: /C_K3 |
| D10 | HL-A-3014H421W-S1-08HL-HR3 | LED_3014_HONGLI_HL-A-3014H421W | 158.900 | 84.000 | 180 | 58.900 | 16.000 | 1: /C_R, 2: /C_K4 |
| D11 | BAW56,215 | SOT-23 | 132.500 | 101.750 | 90 | 32.500 | -1.750 | 1: /W-, 2: /LED_SW, 3: /N_W |
| D12 | BAW56,215 | SOT-23 | 137.500 | 101.750 | 90 | 37.500 | -1.750 | 1: /C-, 2: /LED_SW, 3: /N_C |
| H1 | C0 cover column / float stop | NPTH_4.20mm | 105.000 | 99.500 | 0 | 5.000 | 0.500 | npth: - |
| H2 | C1 cover column / float stop | NPTH_4.20mm | 147.000 | 97.650 | 0 | 47.000 | 2.350 | npth: - |
| H3 | C2 cover column / float stop | NPTH_4.20mm | 160.900 | 102.540 | 0 | 60.900 | -2.540 | npth: - |
| H4 | DL carrier datum pin, left | NPTH_1.60mm | 97.600 | 84.000 | 0 | -2.400 | 16.000 | npth: - |
| H5 | DR carrier datum pin, right | NPTH_1.60mm | 162.400 | 84.000 | 0 | 62.400 | 16.000 | npth: - |
| H6 | SA carrier glue point (epoxy), -Z flange | NPTH_1.60mm | 115.000 | 86.900 | 0 | 15.000 | 13.100 | npth: - |
| H7 | SB carrier glue point (epoxy), -Z flange | NPTH_1.60mm | 145.000 | 86.900 | 0 | 45.000 | 13.100 | npth: - |
| H8 | SC carrier glue point (epoxy), +Z flange | NPTH_1.60mm | 115.000 | 81.700 | 0 | 15.000 | 18.300 | npth: - |
| H9 | SD carrier glue point (epoxy), +Z flange | NPTH_1.60mm | 145.000 | 81.700 | 0 | 45.000 | 18.300 | npth: - |
| J1 | TSW-102-14-G-D-004 | J6_PLUG_3PIN | 155.932 | 102.540 | 0 | 55.932 | -2.540 | 5: /LED_SW, 6: /W-, 11: /C- |
| R1 | CRCW0805200RFKEAHP | R_0805_2012Metric | 132.500 | 97.950 | -90 | 32.500 | 2.050 | 1: /W_R, 2: /N_W |
| R2 | CRCW0805200RFKEAHP | R_0805_2012Metric | 137.500 | 97.950 | -90 | 37.500 | 2.050 | 1: /C_R, 2: /N_C |

## Copper by net

| Net | F.Cu mm | B.Cu mm | widths | vias |
|---|---|---|---|---|
| /C- | 21.9 | 0.0 | [0.4] | [] |
| /C_K1 | 13.0 | 0.0 | [0.25] | [] |
| /C_K2 | 13.0 | 0.0 | [0.25] | [] |
| /C_K3 | 13.0 | 0.0 | [0.25] | [] |
| /C_K4 | 13.0 | 0.0 | [0.25] | [] |
| /C_R | 34.5 | 0.0 | [0.4] | [] |
| /LED_SW | 13.2 | 96.9 | [0.25, 0.4] | [(133.45, 104.2), (99.87, 89.0), (139.9, 102.688)] |
| /N_C | 1.9 | 0.0 | [0.4] | [] |
| /N_W | 1.9 | 0.0 | [0.4] | [] |
| /W- | 29.1 | 0.0 | [0.4] | [] |
| /W_K1 | 13.8 | 0.0 | [0.25] | [] |
| /W_K2 | 13.8 | 0.0 | [0.25] | [] |
| /W_K3 | 13.8 | 0.0 | [0.25] | [] |
| /W_K4 | 13.8 | 0.0 | [0.25] | [] |
| /W_R | 35.7 | 0.0 | [0.4] | [] |

## Handedness / placement gate (tools/check_handedness.py)

- PASS exactly 3 plated through-holes, all on J1 (found 3)
- PASS J1 '5' at E (54.662, -3.810) vs J6-5 (54.662, -3.810): 0.0000 <= 0.02
- PASS J1 '5' via the STEP chain: E (54.662, Y 118.61, -3.810) agrees
- PASS J1 '5' net LED_SW == J6-5 LED_SW
- PASS J1 '6' at E (57.202, -3.810) vs J6-6 (57.202, -3.810): 0.0000 <= 0.02
- PASS J1 '6' via the STEP chain: E (57.202, Y 118.61, -3.810) agrees
- PASS J1 '6' net W- == J6-6 W-
- PASS J1 '11' at E (54.662, -1.270) vs J6-11 (54.662, -1.270): 0.0000 <= 0.02
- PASS J1 '11' via the STEP chain: E (54.662, Y 118.61, -1.270) agrees
- PASS J1 '11' net C- == J6-11 C-
- PASS STEP->E rotation determinant 1 (proper rotation)
- PASS J6-12 P+_FUSE at E (57.202, -1.27): nearest copper 1.690, nearest hole 1.810 (>= 1.0)
- PASS J6-4 GND at E (52.122, -3.81): nearest copper 1.290, nearest hole 2.030 (>= 1.0)
- PASS 9 NPTH holes (params: 9)
- PASS NPTH C0 dia 4.2 at E (5.0, 0.5)
- PASS NPTH C1 dia 4.2 at E (47.0, 2.35)
- PASS NPTH C2 dia 4.2 at E (60.9, -2.54)
- PASS NPTH DL dia 1.6 at E (-2.4, 16.0)
- PASS NPTH DR dia 1.6 at E (62.4, 16.0)
- PASS NPTH SA dia 1.6 at E (15.0, 13.1)
- PASS NPTH SB dia 1.6 at E (45.0, 13.1)
- PASS NPTH SC dia 1.6 at E (15.0, 18.3)
- PASS NPTH SD dia 1.6 at E (45.0, 18.3)
- PASS copper to NPTH edge min 0.525 >= 0.4
- PASS tracks to NPTH edge min 0.525 >= 0.5
- PASS D1 on F.Cu
- PASS D1 courtyard E x -0.78..2.98 z 15.05..16.95: clear of keep-outs
- PASS R1 on F.Cu
- PASS R1 courtyard E x 31.55..33.45 z 0.37..3.73: clear of keep-outs
- PASS D6 on F.Cu
- PASS D6 courtyard E x 3.02..6.78 z 15.05..16.95: clear of keep-outs
- PASS D10 on F.Cu
- PASS D10 courtyard E x 57.02..60.78 z 15.05..16.95: clear of keep-outs
- PASS D7 on F.Cu
- PASS D7 courtyard E x 16.52..20.28 z 15.05..16.95: clear of keep-outs
- PASS D2 on F.Cu
- PASS D2 courtyard E x 12.72..16.48 z 15.05..16.95: clear of keep-outs
- PASS R2 on F.Cu
- PASS R2 courtyard E x 36.55..38.45 z 0.37..3.73: clear of keep-outs
- PASS D12 on F.Cu
- PASS D12 courtyard E x 35.80..39.20 z -3.68..0.18: clear of keep-outs
- PASS D5 on F.Cu
- PASS D5 courtyard E x 53.22..56.98 z 15.05..16.95: clear of keep-outs
- PASS D11 on F.Cu
- PASS D11 courtyard E x 30.80..34.20 z -3.68..0.18: clear of keep-outs
- PASS D3 on F.Cu
- PASS D3 courtyard E x 26.22..29.98 z 15.05..16.95: clear of keep-outs
- PASS D9 on F.Cu
- PASS D9 courtyard E x 43.52..47.28 z 15.05..16.95: clear of keep-outs
- PASS D8 on F.Cu
- PASS D8 courtyard E x 30.02..33.78 z 15.05..16.95: clear of keep-outs
- PASS J1 on F.Cu
- INFO J1 body to column hole C2 edge 0.328 (exception >= 0.30, PROGRESS deviation)
- PASS J1 courtyard E x 53.39..58.47 z -5.08..0.00: clear of keep-outs
- PASS D4 on F.Cu
- PASS D4 courtyard E x 39.72..43.48 z 15.05..16.95: clear of keep-outs
- PASS NPTH C2 dia 4.2 at E (60.9, -2.54): web to board edge 0.500 >= 0.5
- PASS NPTH SC dia 1.6 at E (15.0, 18.3): web to board edge 0.500 >= 0.5
- PASS NPTH SD dia 1.6 at E (45.0, 18.3): web to board edge 0.500 >= 0.5
- PASS NPTH DR dia 1.6 at E (62.4, 16.0): web to board edge 1.000 >= 0.5
- PASS NPTH DL dia 1.6 at E (-2.4, 16.0): web to board edge 1.000 >= 0.5
- PASS NPTH C0 dia 4.2 at E (5.0, 0.5): web to board edge 4.600 >= 0.5
- PASS NPTH SA dia 1.6 at E (15.0, 13.1): web to board edge 5.700 >= 0.5
- PASS NPTH SB dia 1.6 at E (45.0, 13.1): web to board edge 5.700 >= 0.5
- PASS NPTH C1 dia 4.2 at E (47.0, 2.35): web to board edge 6.450 >= 0.5
- INFO outline 14 Edge.Cuts primitives; min NPTH web 0.500 (C2)
- PASS silk: 44 strokes, min width 0.150 >= 0.15
- PASS silk: 8 visible texts, min height 1.000, min stroke 0.150; W/C markers at >= 1.0
