iandchasse/silkscreen-light-attachment/design/optics/optics_external_map.png

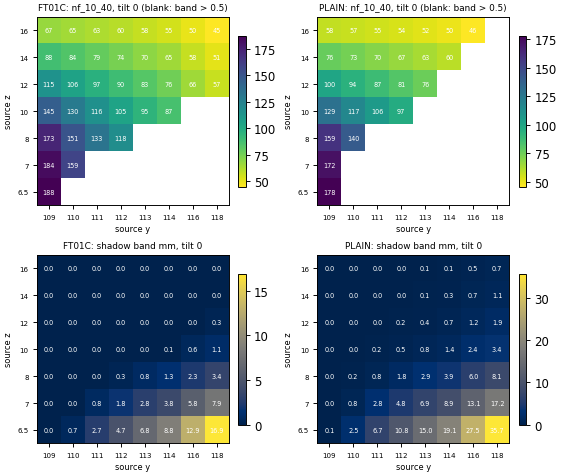
design/optics/optics_external_map.png
