iandchasse/silkscreen-light-attachment/design/optics/optics_heatmaps.png

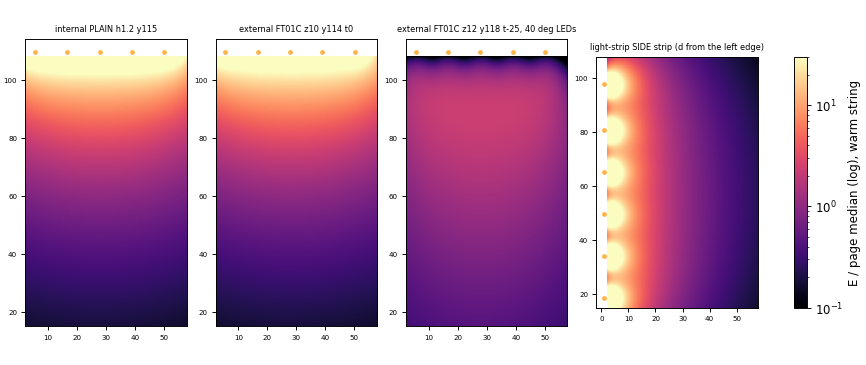
design/optics/optics_heatmaps.png
