iandchasse/silkscreen-light-attachment/design/optics/optics_profiles.png

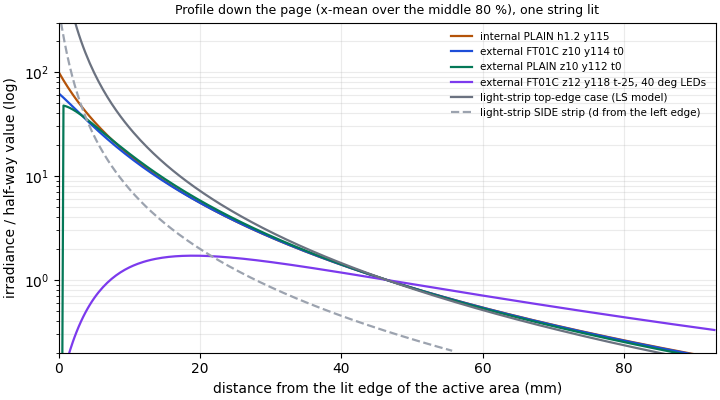
design/optics/optics_profiles.png
