iandchasse/silkscreen-light-attachment/design/optics/rod_final.png

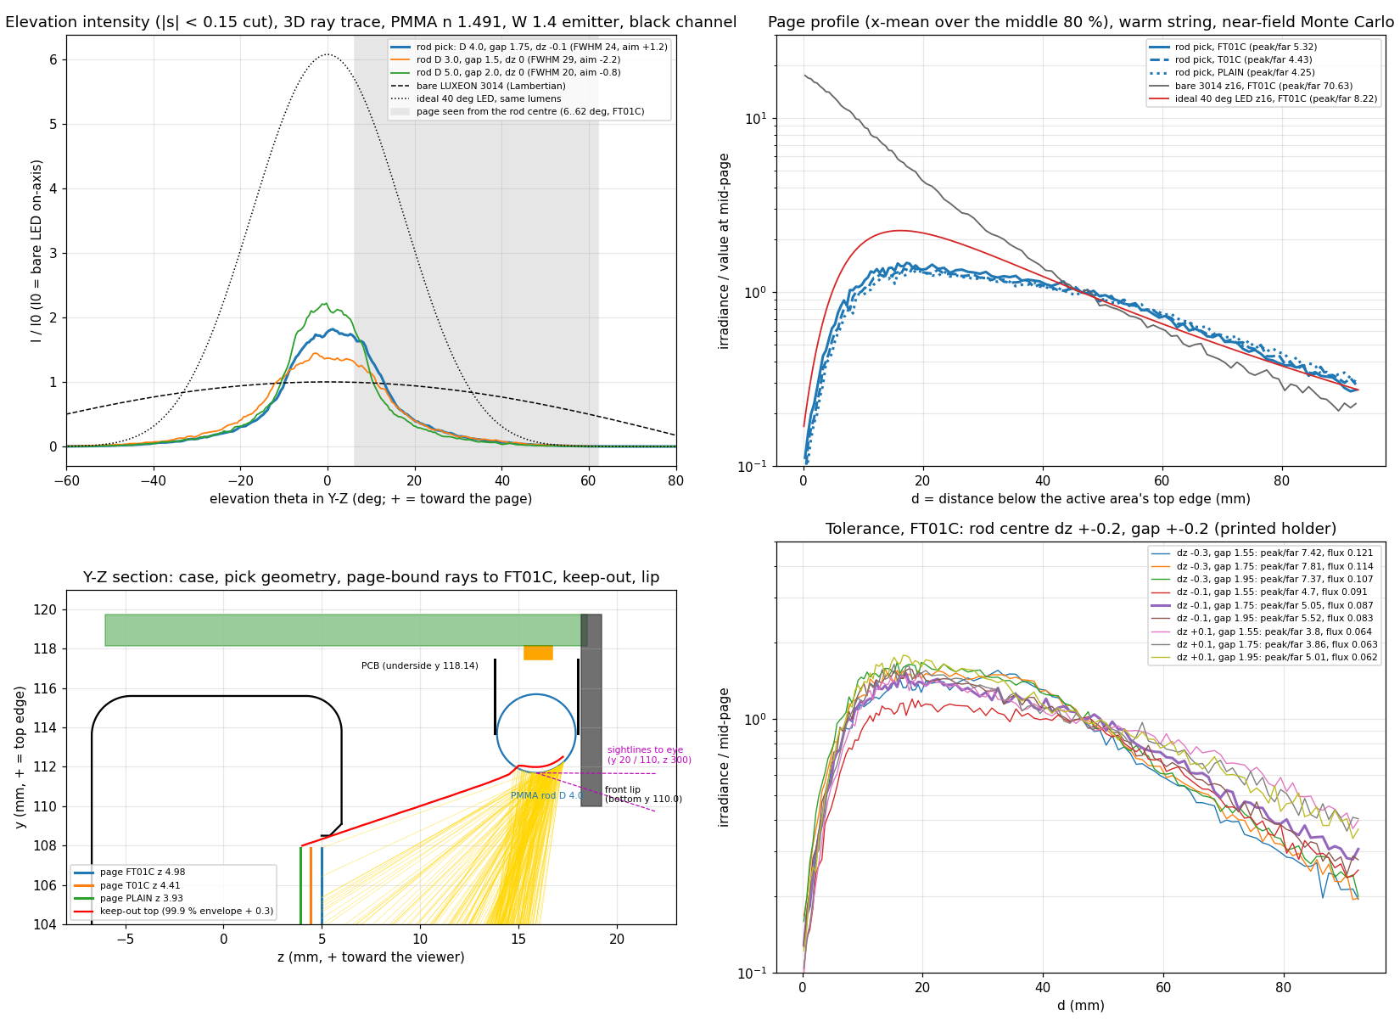
design/optics/rod_final.png
