iandchasse/silkscreen-light-attachment/housing/out/render/front.png

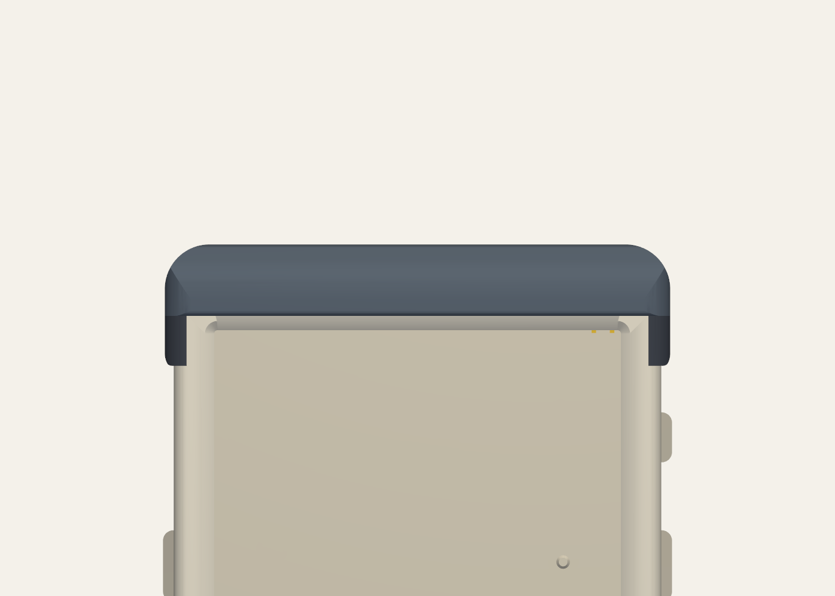
housing/out/render/front.png
