iandchasse/silkscreen-light-attachment/housing/out/render/hood_corner_iso.png

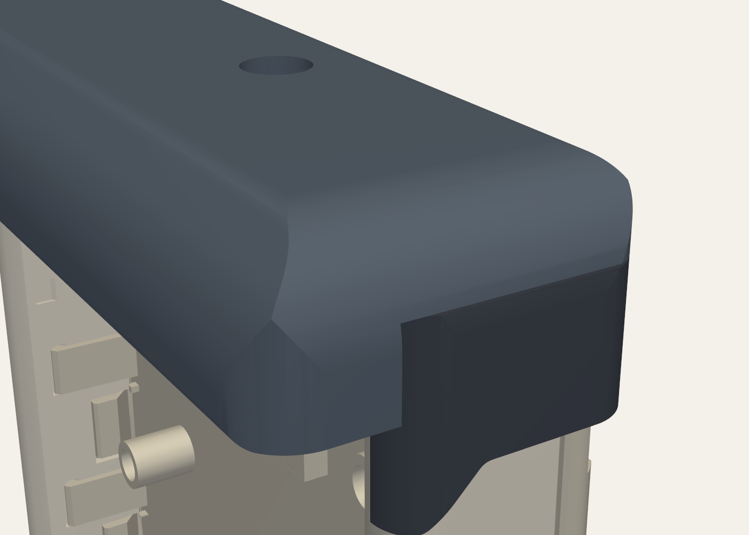
housing/out/render/hood_corner_iso.png
