iandchasse/silkscreen-light-attachment/housing/out/render/hood_from_below.png

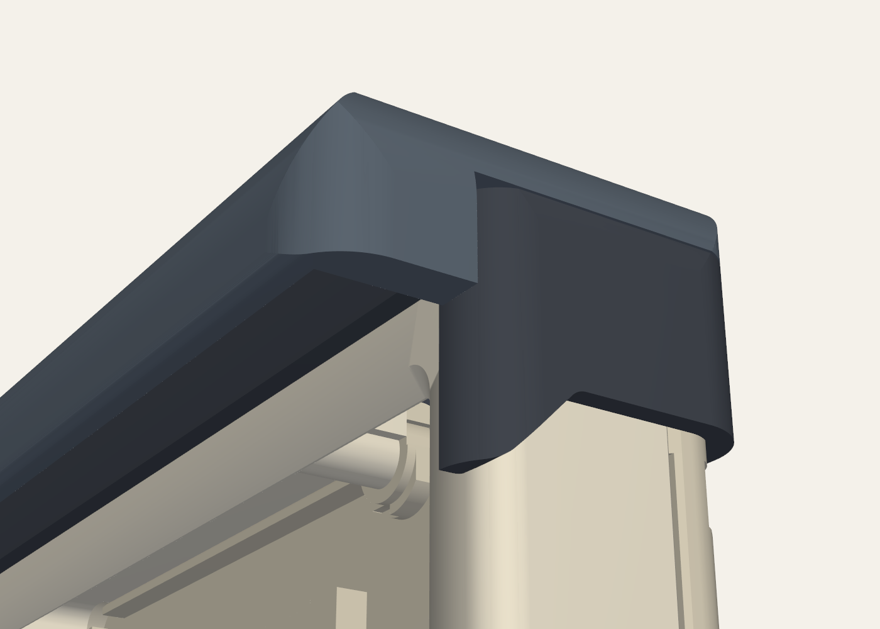
housing/out/render/hood_from_below.png
