iandchasse/silkscreen-light-attachment/housing/out/render/section_boss_x10.png

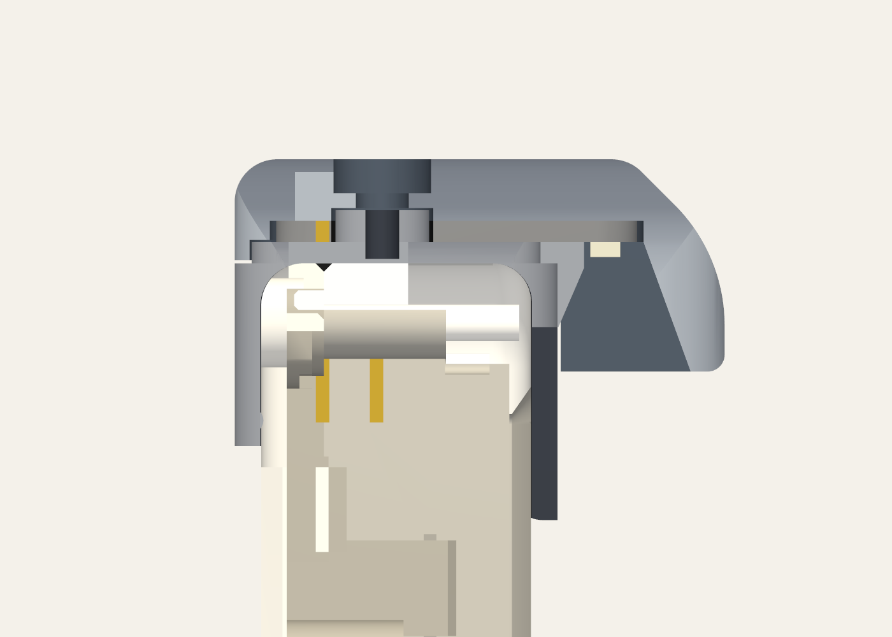
housing/out/render/section_boss_x10.png
