iandchasse/silkscreen-light-attachment/housing/out/render/section_hood_end_x-4.png

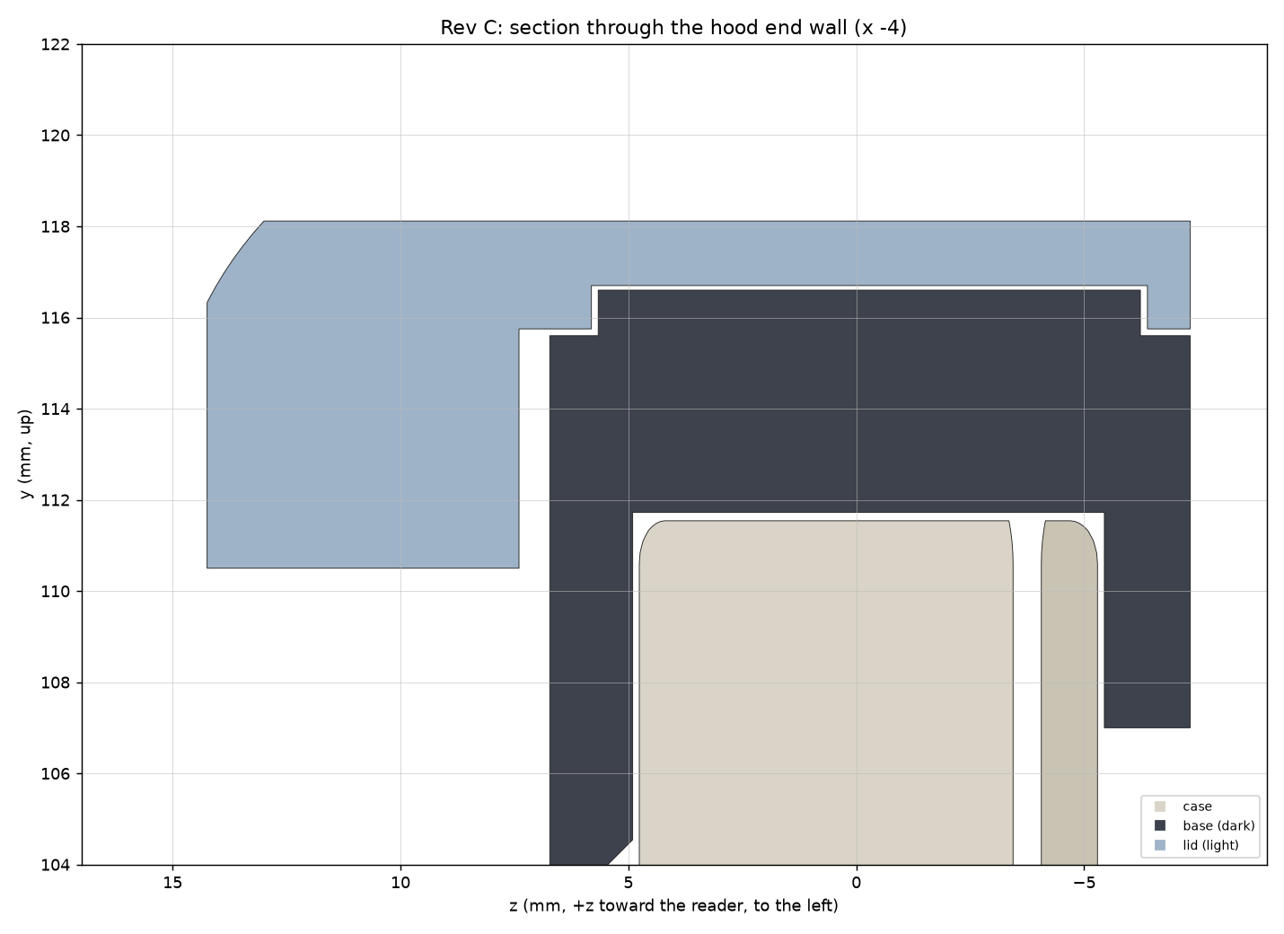
housing/out/render/section_hood_end_x-4.png
