iandchasse/silkscreen-light-attachment/housing/out/render/section_led_row_x28.1.png

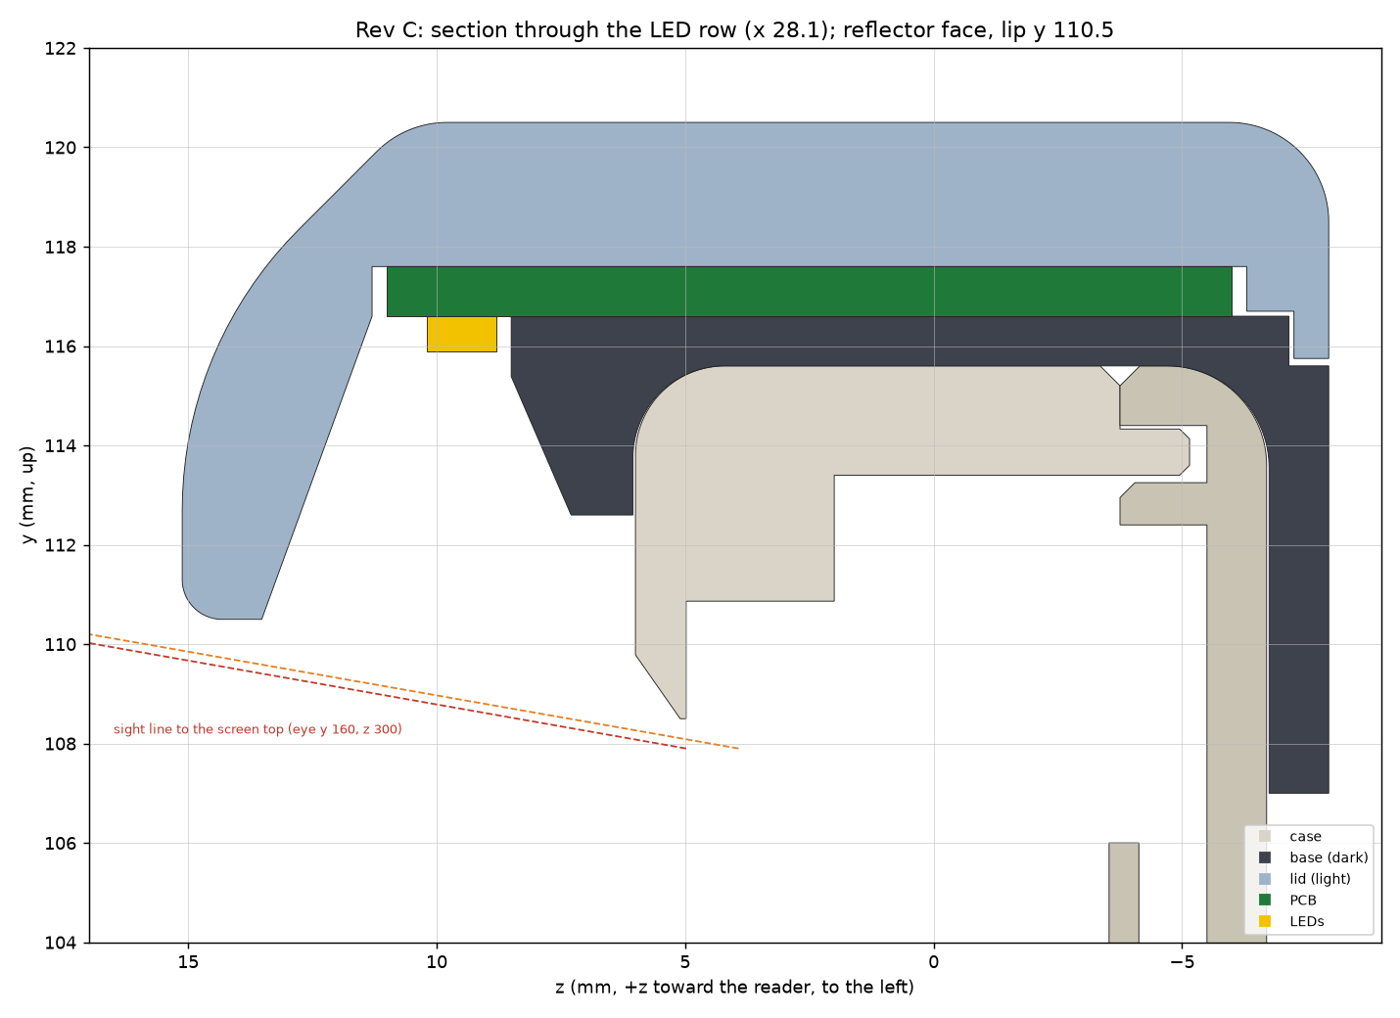
housing/out/render/section_led_row_x28.1.png
