iandchasse/silkscreen-light-attachment/housing/out/render/side_right.png

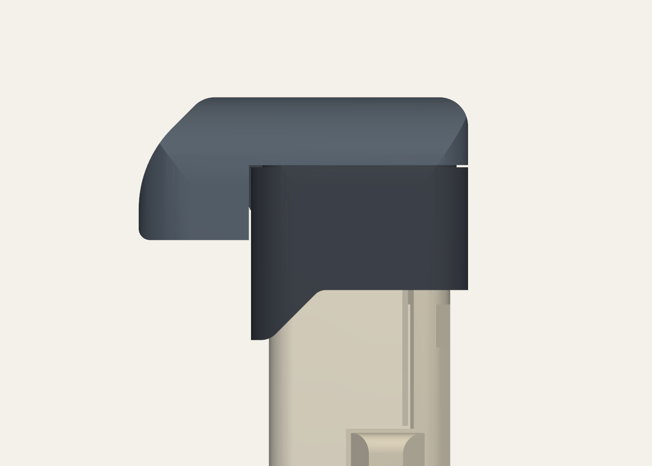
housing/out/render/side_right.png
