iandchasse/silkscreen-light-attachment/pcb/production/bom.csv

Qty | Refs | Value | Manufacturer | MPN | DigiKey | LCSC | JLC type | Footprint | Assembly | Description
5 | D1,D2,D3,D4,D5 | HL-A-3014H421W-S1-08HL-HR3 | HONGLITRONIC | HL-A-3014H421W-S1-08HL-HR3 | n/a - LCSC only (C210340 warm / C210343 cool) | C210340 | JLC Extended | LED_3014_HONGLI_HL-A-3014H421W | JLC SMT (F side) | Warm white LED 3000 K (bin WS 2800-3100 K), LCSC C210340; 3014 top view 3.0x1.4x0.7; the MPN is shared by every CCT - order by the LCSC code
5 | D6,D7,D8,D9,D10 | HL-A-3014H421W-S1-08HL-HR3 | HONGLITRONIC | HL-A-3014H421W-S1-08HL-HR3 | n/a - LCSC only (C210340 warm / C210343 cool) | C210343 | JLC Extended | LED_3014_HONGLI_HL-A-3014H421W | JLC SMT (F side) | Cool white LED 6000 K (bin 60-5 5700-6500 K), LCSC C210343; 3014 top view 3.0x1.4x0.7; the MPN is shared by every CCT - order by the LCSC code
1 | J1 | HC-PZ254-11.5L-1x2PZ | Hong Cheng | HC-PZ254-11.5L-1x2PZ | Harwin M20-9990246 (DigiKey product 3728226) - 6.1 mm post | C27985187 | JLC Extended | J6_PLUG_1x2_P5_P6 | THT: JLC hand-solders it, or untick it at JLC and solder it yourself | 1x2 2.54 mm straight male pin header, body 2.5, mating post 6.0, tail 3.0, 0.64 sq; body on the LED side, soldered by the builder on the plain side; pins = J6 5/6
1 | J2 | HC-PZ254-11.5L-1x1PZ | Hong Cheng | HC-PZ254-11.5L-1x1PZ | 1 pin cut from Harwin M20-9990246 (DigiKey product 3728226) | C27985186 | JLC Extended | J6_PLUG_1x1_P11 | THT: JLC hand-solders it, or untick it at JLC and solder it yourself | 1x1 2.54 mm straight male pin header, body 2.5, mating post 6.0, tail 3.0, 0.64 sq; body on the LED side, soldered by the builder on the plain side; pins = J6 11
2 | R1,R2 | CRCW0805200RFKEAHP | Vishay Dale | CRCW0805200RFKEAHP | 541-CRCW0805200RFKEAHPCT-ND | C5972814 | JLC Extended | R_0805_2012Metric | JLC SMT (F side) | 200 R 1 % 0.5 W pulse-proof thick film 0805 (CRCW-HP); string series resistor
