iandchasse/silkscreen-light-attachment/pcb/production/jlc_bom.csv

Comment | Designator | Footprint | JLCPCB Part #
HL-A-3014H421W-S1-08HL-HR3 3000 K | D1,D2,D3,D4,D5 | LED_3014_HONGLI_HL-A-3014H421W | C210340
HL-A-3014H421W-S1-08HL-HR3 6000 K | D6,D7,D8,D9,D10 | LED_3014_HONGLI_HL-A-3014H421W | C210343
HC-PZ254-11.5L-1x2PZ | J1 | J6_PLUG_1x2_P5_P6 | C27985187
HC-PZ254-11.5L-1x1PZ | J2 | J6_PLUG_1x1_P11 | C27985186
CRCW0805200RFKEAHP | R1,R2 | R_0805_2012Metric | C5972814
