iandchasse/silkscreen-light-attachment/housing/out/print/base.step

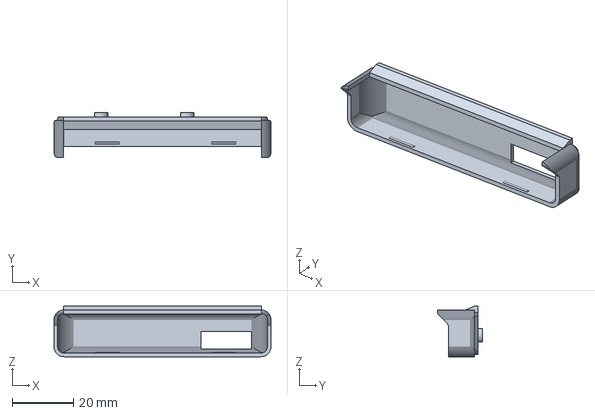
[picture p15: CAD file, 2026-10-21]
housing/out/print/base.step
70.7 x 14.6 x 16.4 mm
