iandchasse/silkscreen-light-attachment/housing/reference/case-426-standard/tub.stl

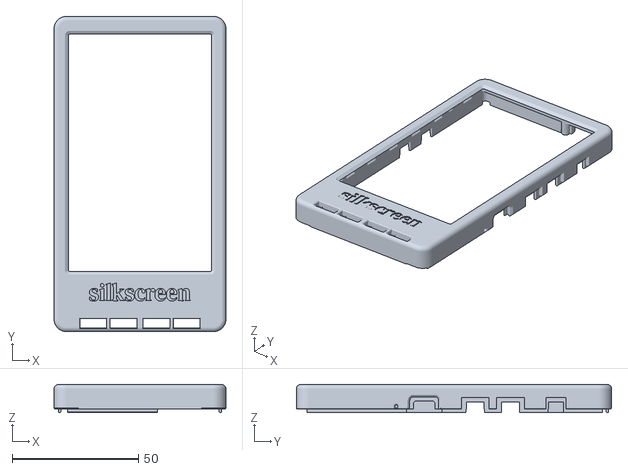
[picture p16: CAD file, 2026-10-21]
housing/reference/case-426-standard/tub.stl
68.2 x 125.0 x 11.2
