iandchasse/silkscreen-light-attachment/pcb/production/3d/silkscreen-light-attachment_pcba_E.step

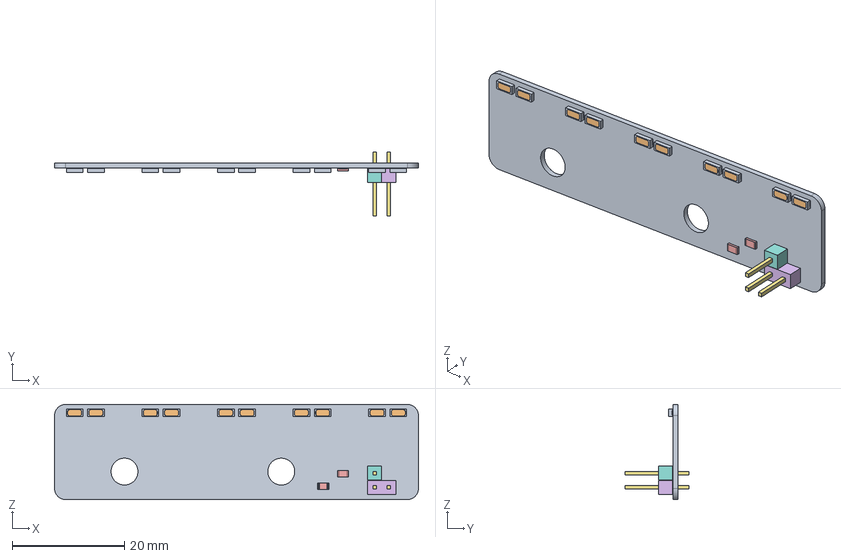
[picture p17: CAD file, 2026-10-21]
pcb/production/3d/silkscreen-light-attachment_pcba_E.step
65.0 x 11.5 x 17.0 mm
