iandchasse/silkscreen-light-attachment/housing/out/print/plate.3mf

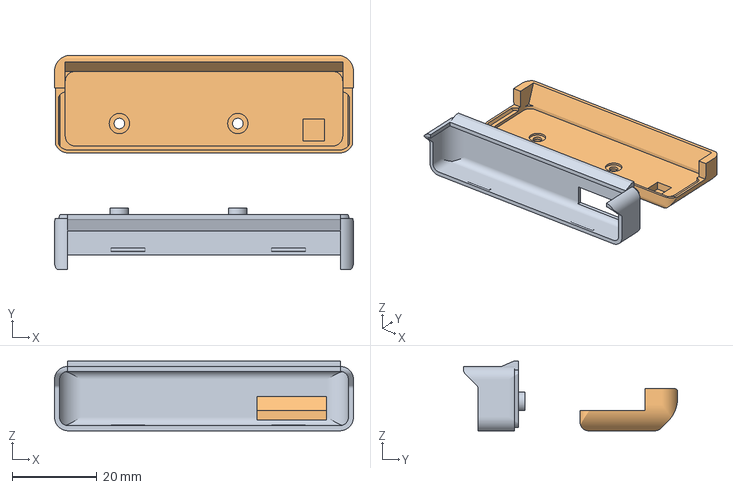
[picture p18: CAD file, 2026-10-21]
housing/out/print/plate.3mf
70.7 x 50.7 x 16.4 mm
geometry_0
geometry_1
