iandchasse/silkscreen-light-attachment/housing/reference/case-426-standard/lid.stl

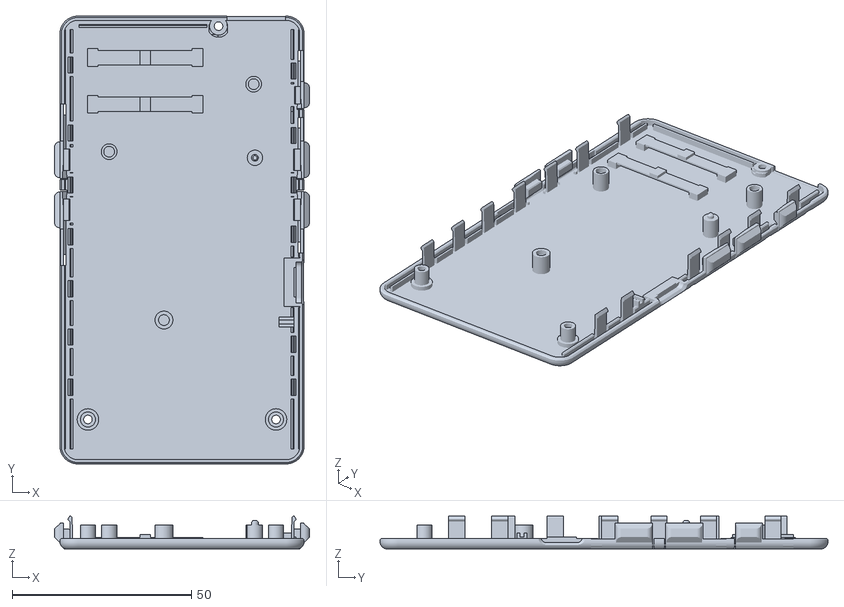
[picture p19: CAD file, 2026-10-21]
housing/reference/case-426-standard/lid.stl
71.2 x 125.0 x 9.19
