iandchasse/silkscreen-light-attachment/housing/out/print/lid.step

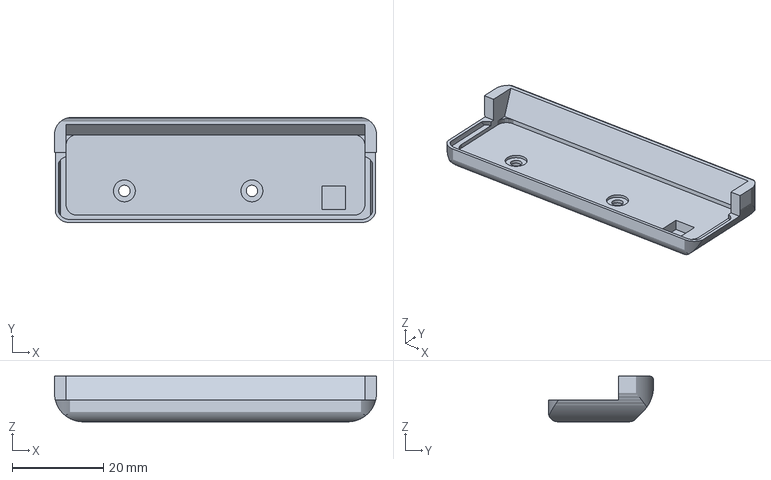
[picture p20: CAD file, 2026-10-21]
housing/out/print/lid.step
70.7 x 23.1 x 10.0 mm
