iandchasse/silkscreen-light-attachment/archive/rev-A-rod-lens/housing/out/print/cover.step

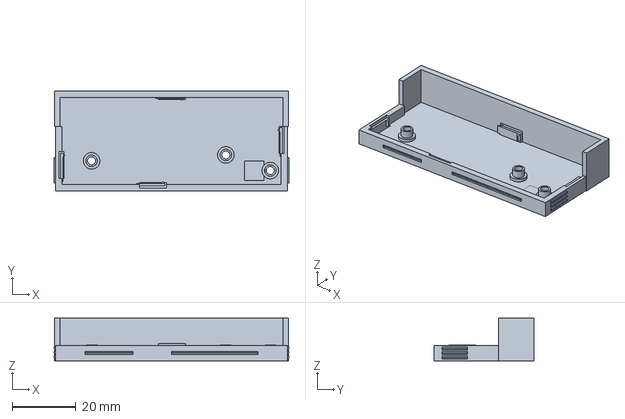
[picture p21: CAD file, 2026-10-21, an earlier design]
archive/rev-A-rod-lens/housing/out/print/cover.step
73.5 x 31.3 x 13.4 mm
