iandchasse/silkscreen-light-attachment/archive/rev-A-rod-lens/pcb/production/3d/silkscreen-light-attachment.step

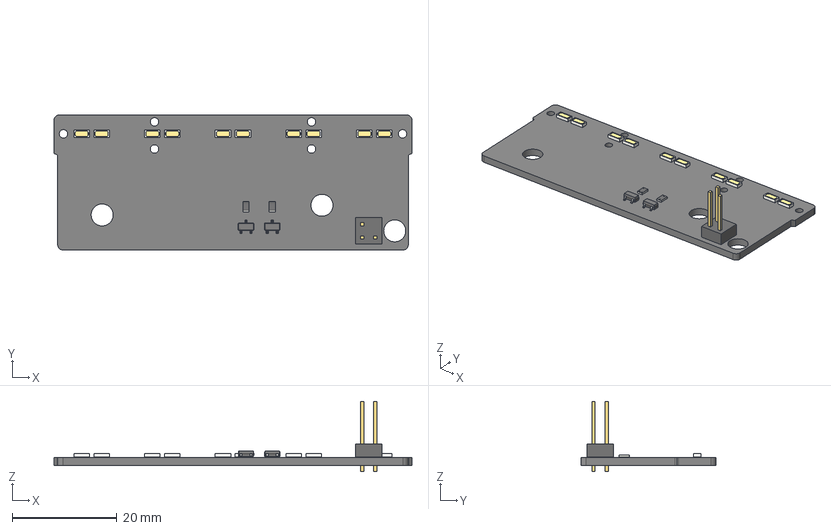
[picture p22: CAD file, 2026-10-21, an earlier design]
archive/rev-A-rod-lens/pcb/production/3d/silkscreen-light-attachment.step
68.4 x 25.8 x 13.5 mm
housing x 10
lens x 10
k_terminal x 10
a_terminal x 10
R_0805_2012Metric x 2
SOT-23 x 2
pin_5
pin_6
pin_11
silkscreen-light-attachment_PCB
