iandchasse/silkscreen-light-attachment/archive/rev-B-housing/print/lid.step

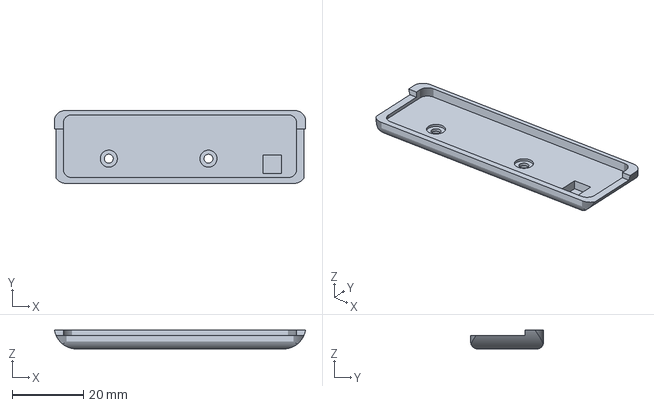
[picture p23: CAD file, 2026-10-21, an earlier design]
archive/rev-B-housing/print/lid.step
70.5 x 20.4 x 5.30 mm
