iandchasse/silkscreen-light-attachment/archive/rev-A-rod-lens/housing/out/print/carrier.step

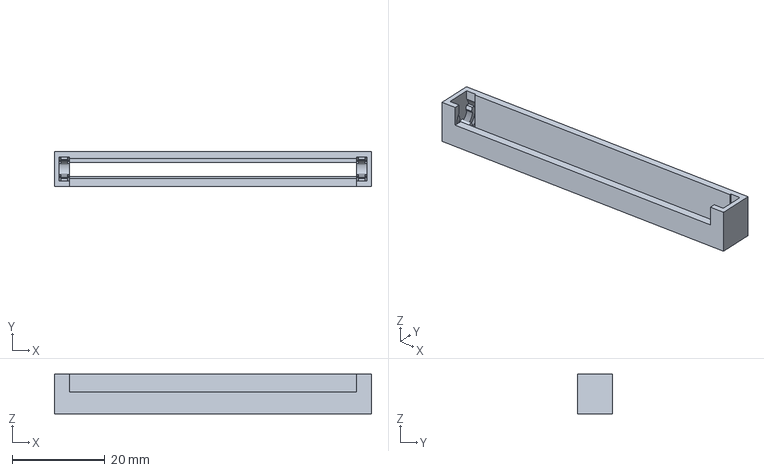
[picture p24: CAD file, 2026-10-21, an earlier design]
archive/rev-A-rod-lens/housing/out/print/carrier.step
68.4 x 7.60 x 8.61 mm
