iandchasse/silkscreen-light-attachment/archive/rev-B-housing/print/plate.3mf

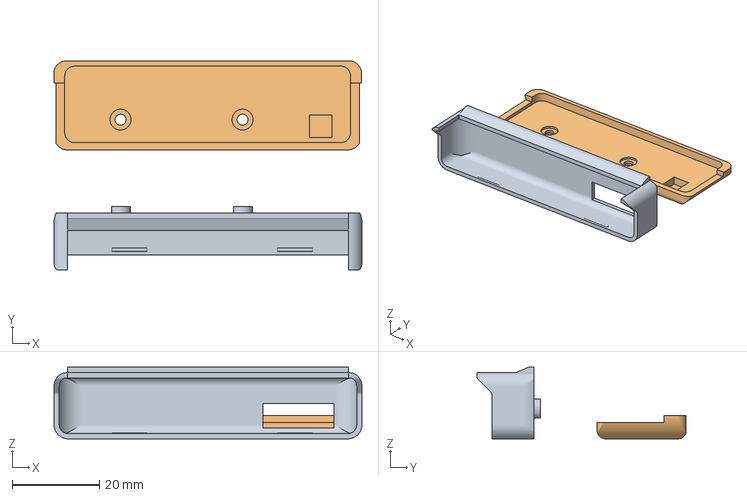
[picture p25: CAD file, 2026-10-21, an earlier design]
archive/rev-B-housing/print/plate.3mf
70.7 x 48.0 x 16.4 mm
geometry_0
geometry_1
