iandchasse/silkscreen-light-attachment/archive/rev-A-rod-lens/housing/out/print/clip.step

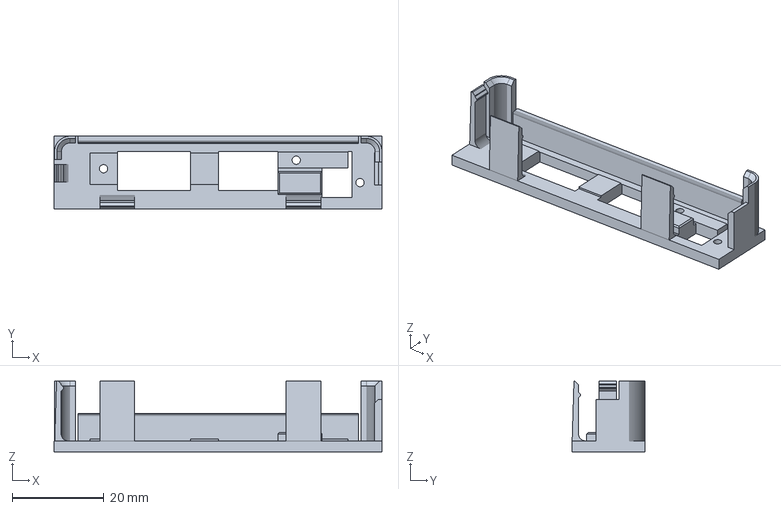
[picture p26: CAD file, 2026-10-21, an earlier design]
archive/rev-A-rod-lens/housing/out/print/clip.step
71.5 x 15.8 x 15.4 mm
