iandchasse/silkscreen-light-attachment/archive/rev-A-rod-lens/housing/out/print/housing-plate.3mf

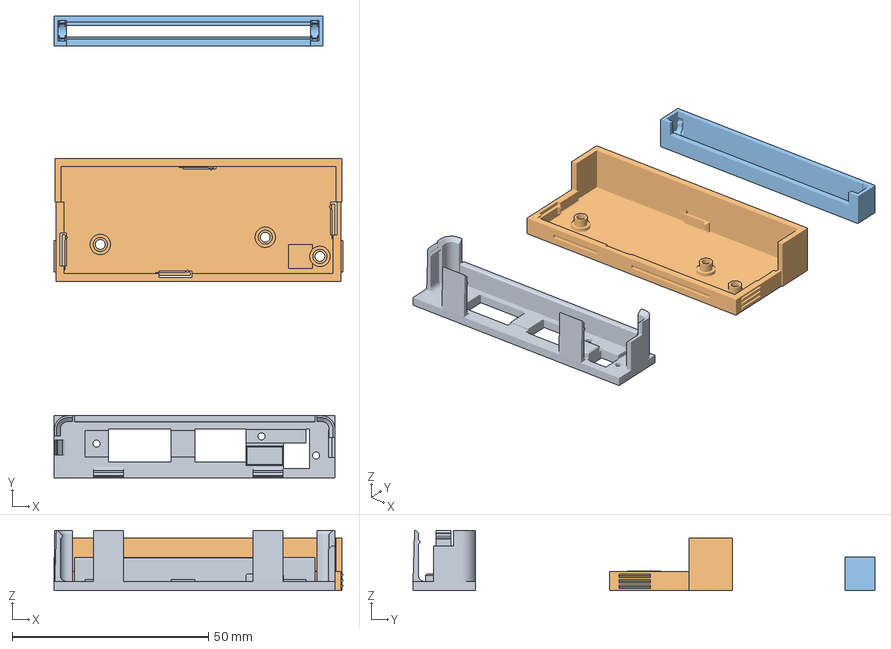
[picture p27: CAD file, 2026-10-21, an earlier design]
archive/rev-A-rod-lens/housing/out/print/housing-plate.3mf
73.5 x 117.6 x 15.4 mm
clip
cover
carrier
