iandchasse/silkscreen-light-attachment/(list of files, cad)

Other CAD files:
pcb/production/3d/silkscreen-light-attachment.step
archive/rev-A-rod-lens/pcb/production/3d/silkscreen-light-attachment_pcba_E.step
archive/rev-B-housing/print/base.step
archive/rev-A-rod-lens/housing/out/print/carrier.stl
archive/rev-A-rod-lens/housing/out/print/clip.stl
archive/rev-A-rod-lens/housing/out/print/cover.stl
archive/rev-A-rod-lens/pcb/production/3d/silkscreen-light-attachment_pcba_E.stl
archive/rev-B-housing/print/base.stl
archive/rev-B-housing/print/lid.stl
housing/out/print/base.stl
housing/out/print/lid.stl
pcb/production/3d/silkscreen-light-attachment_pcba_E.stl
