iandchasse/silkscreen-light-attachment/pcb/docs/silkscreen-light-attachment_schematic.pdf

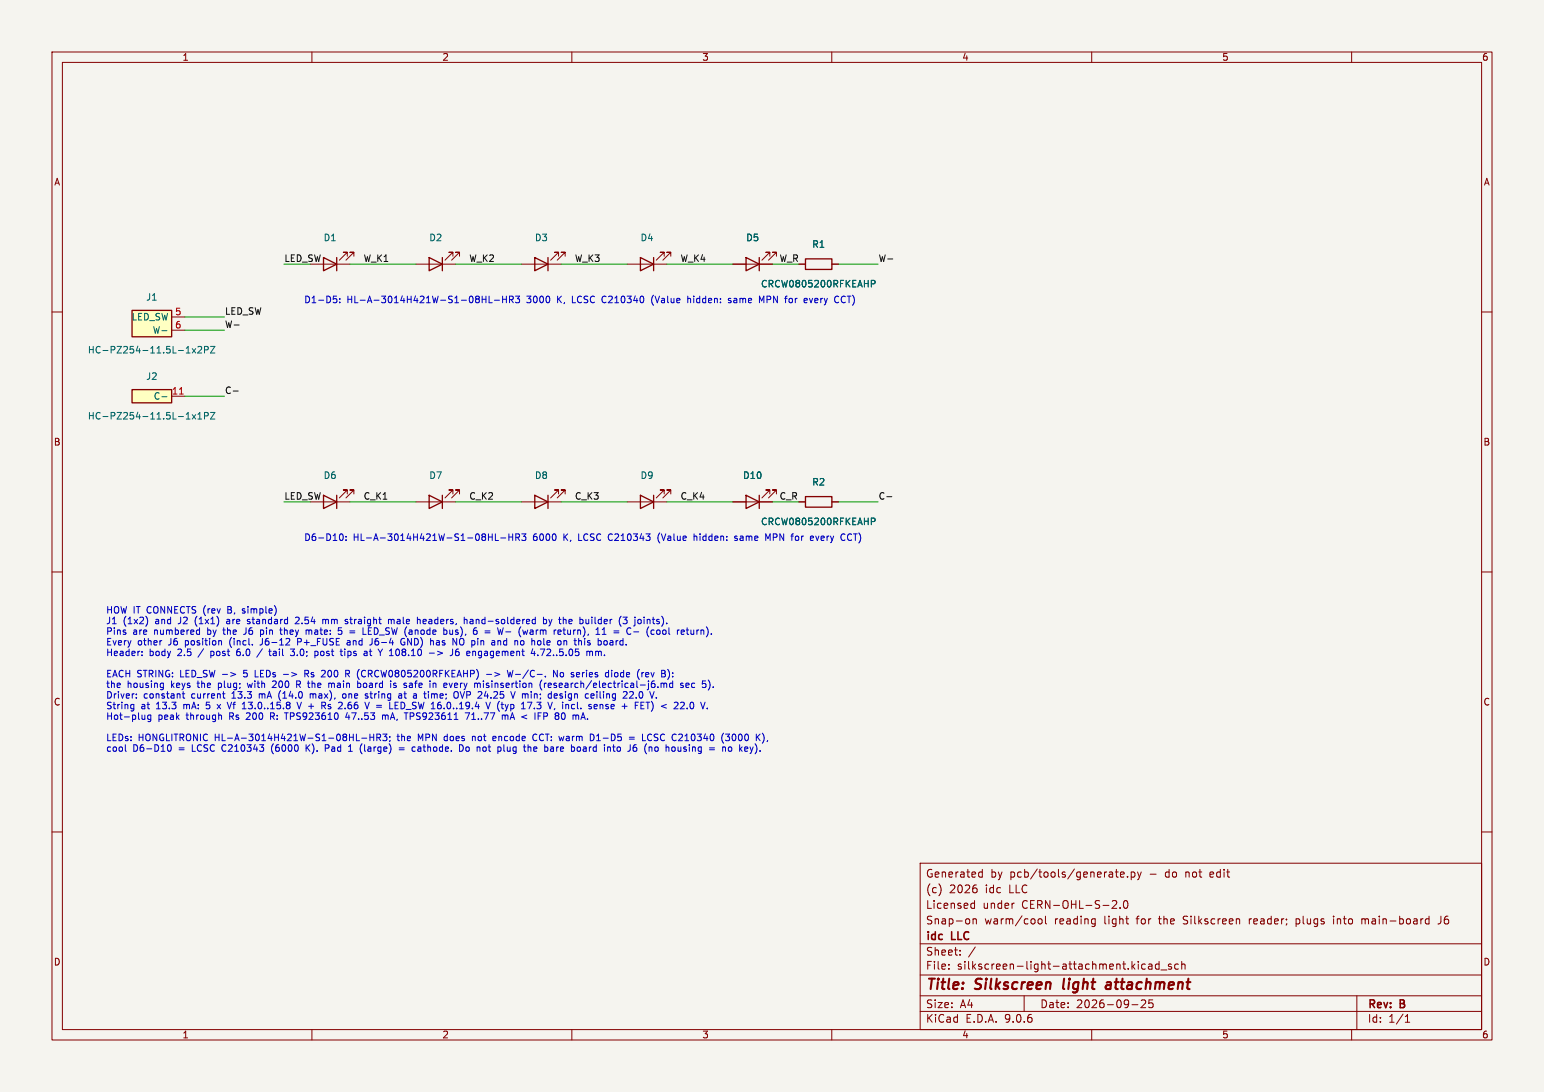
[picture p28: page 1]

Id: 1/1 Title: Silkscreen light attachment File: silkscreen-light-attachment.kicad_sch Sheet: /
