iandchasse/silkscreen-light-attachment/pcb/docs/silkscreen-light-attachment_layout.pdf

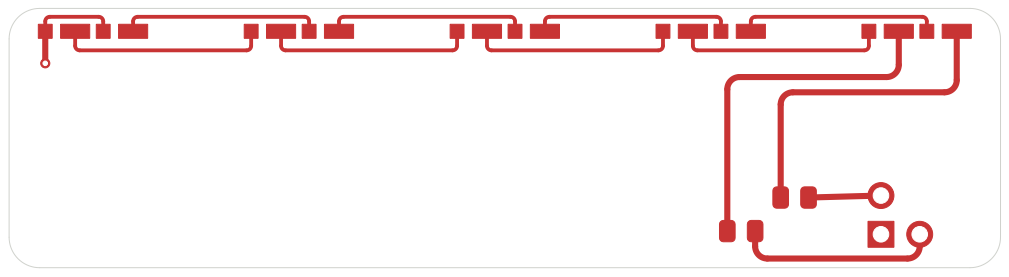
[picture p29: page 1]

Id: 1/9 Title: Silkscreen light attachment File: silkscreen-light-attachment.kicad_pcb Sheet:

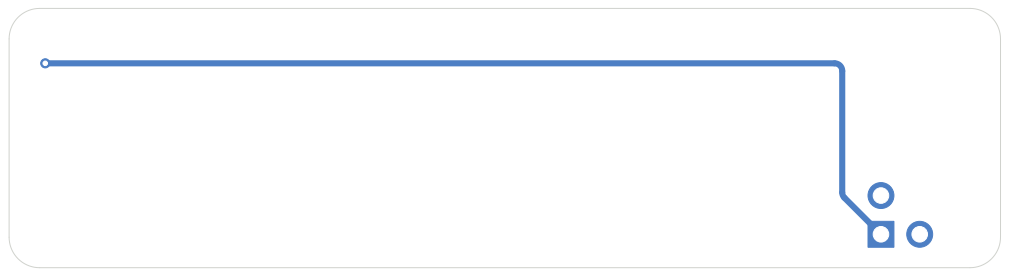
[picture p30: page 2]

Id: 2/9 Title: Silkscreen light attachment File: silkscreen-light-attachment.kicad_pcb Sheet:

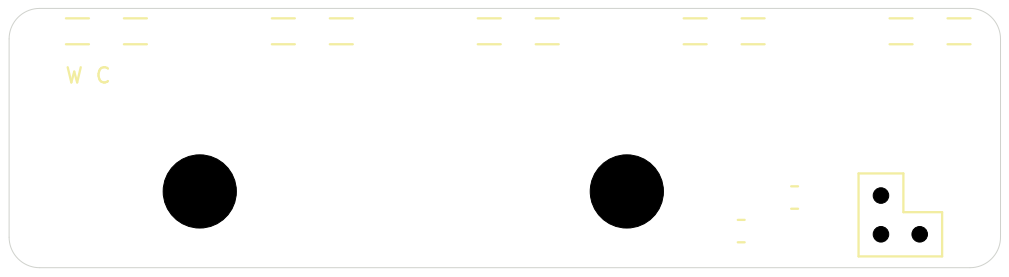
[picture p31: page 3]

Id: 3/9 Title: Silkscreen light attachment File: silkscreen-light-attachment.kicad_pcb Sheet:

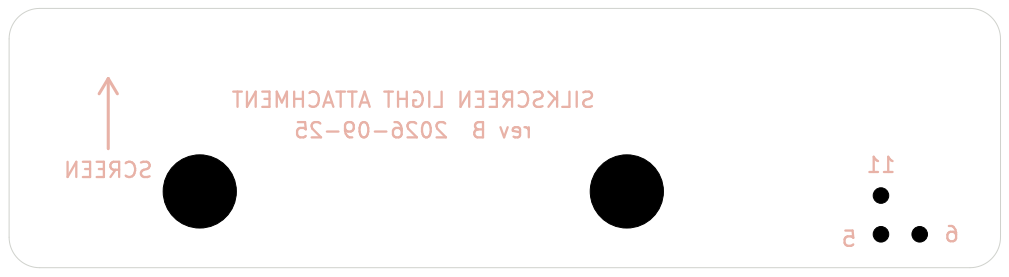
[picture p32: page 4]

Id: 4/9 Title: Silkscreen light attachment File: silkscreen-light-attachment.kicad_pcb Sheet:

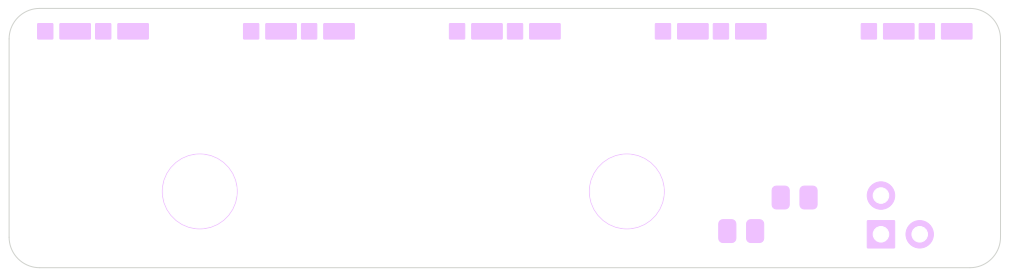
[picture p33: page 5]

Id: 5/9 Title: Silkscreen light attachment File: silkscreen-light-attachment.kicad_pcb Sheet:

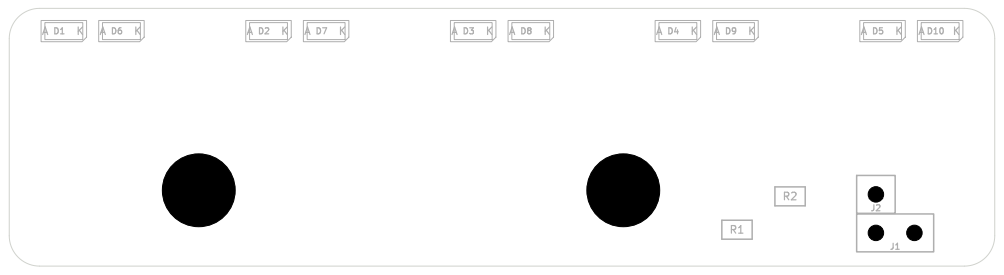
[picture p34: page 6]

Id: 6/9 Title: Silkscreen light attachment File: silkscreen-light-attachment.kicad_pcb Sheet:

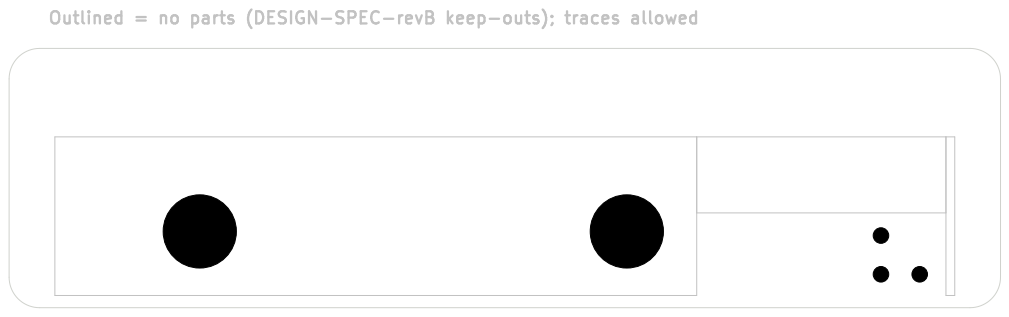
[picture p35: page 7]

Id: 7/9 Title: Silkscreen light attachment File: silkscreen-light-attachment.kicad_pcb Sheet:

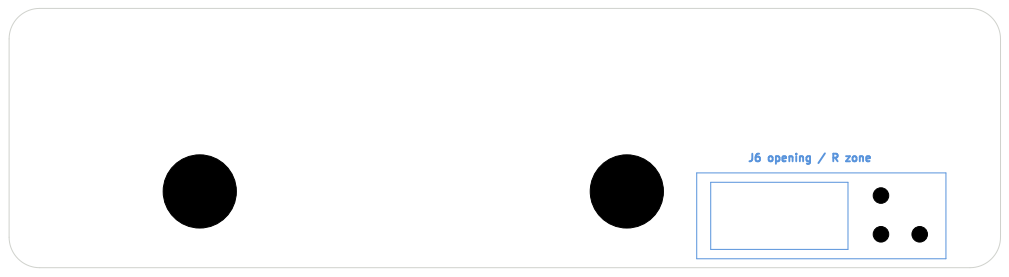
[picture p36: page 8]

Id: 8/9 Title: Silkscreen light attachment File: silkscreen-light-attachment.kicad_pcb Sheet:

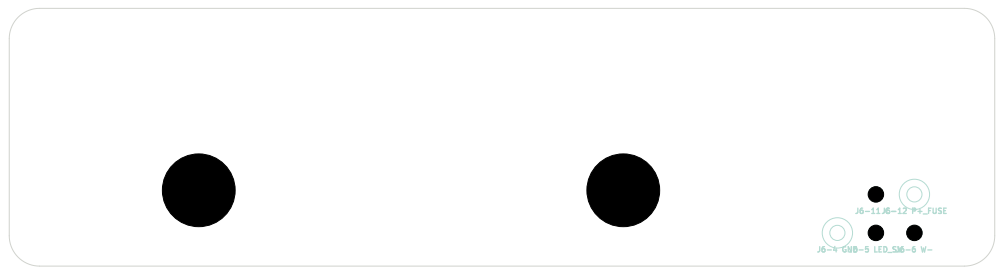
[picture p37: page 9]

Id: 9/9 Title: Silkscreen light attachment File: silkscreen-light-attachment.kicad_pcb Sheet:
