iandchasse/silkscreen-light-attachment/archive/rev-A-rod-lens/pcb/docs/silkscreen-light-attachment_schematic.pdf

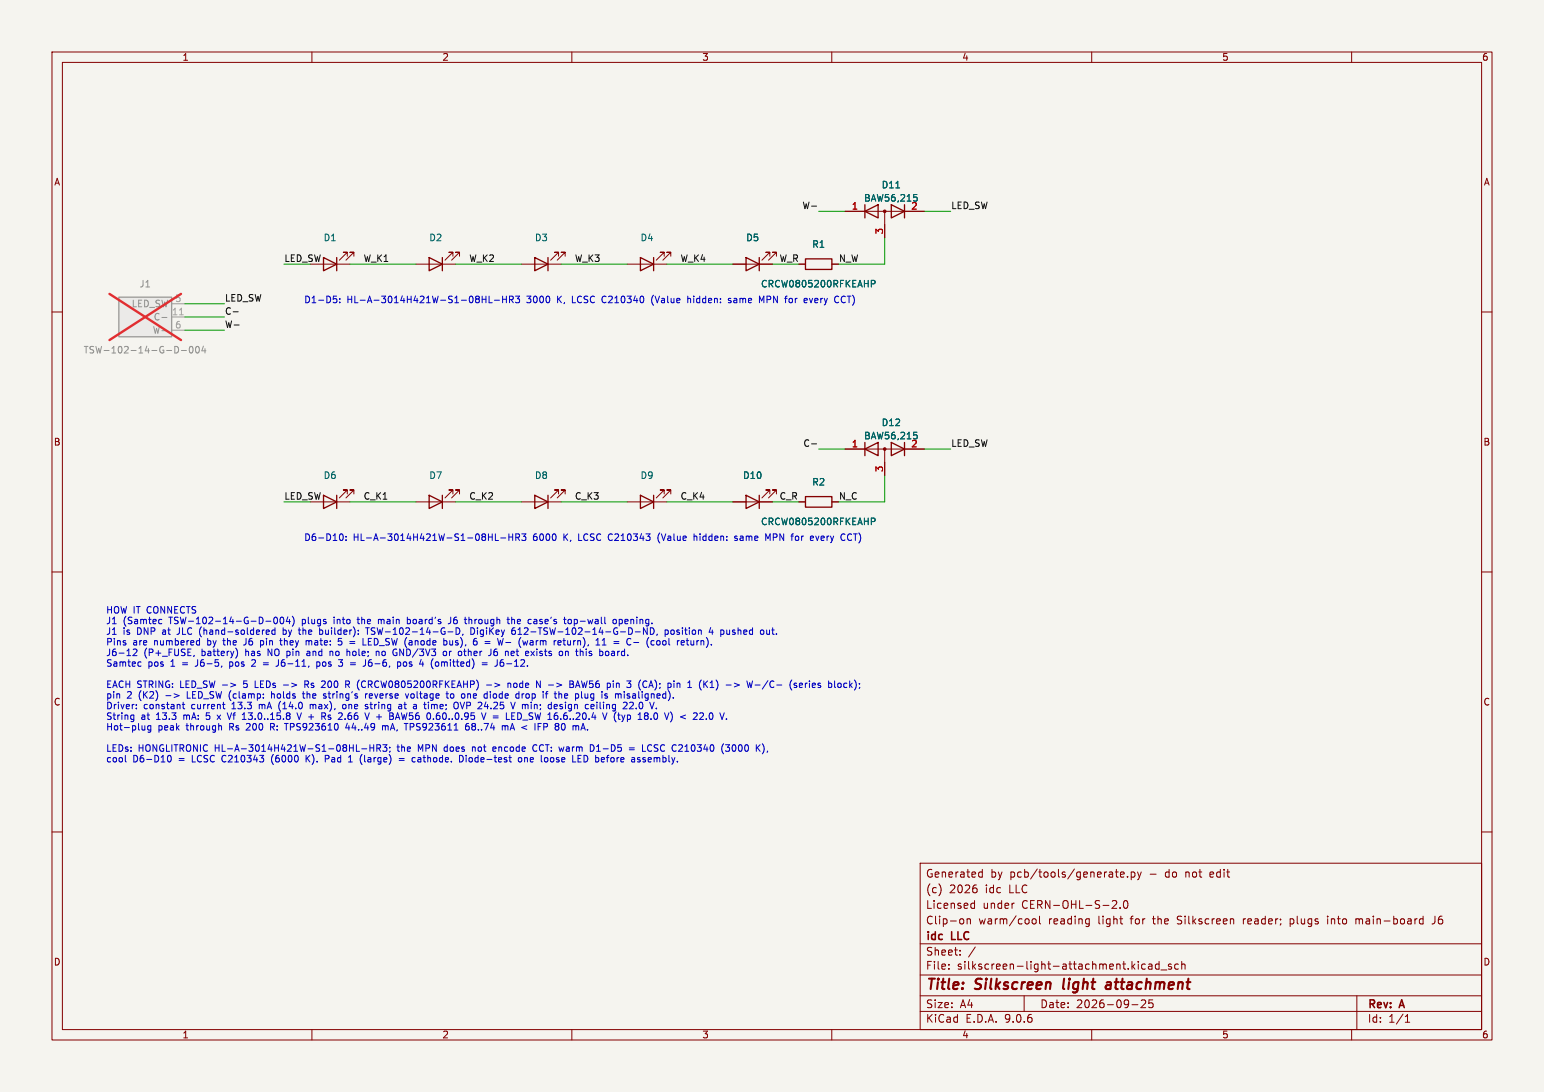
[picture p38: page 1]

Id: 1/1 Title: Silkscreen light attachment File: silkscreen-light-attachment.kicad_sch Sheet: /
