iandchasse/silkscreen-light-attachment/archive/rev-A-rod-lens/pcb/docs/silkscreen-light-attachment_layout.pdf

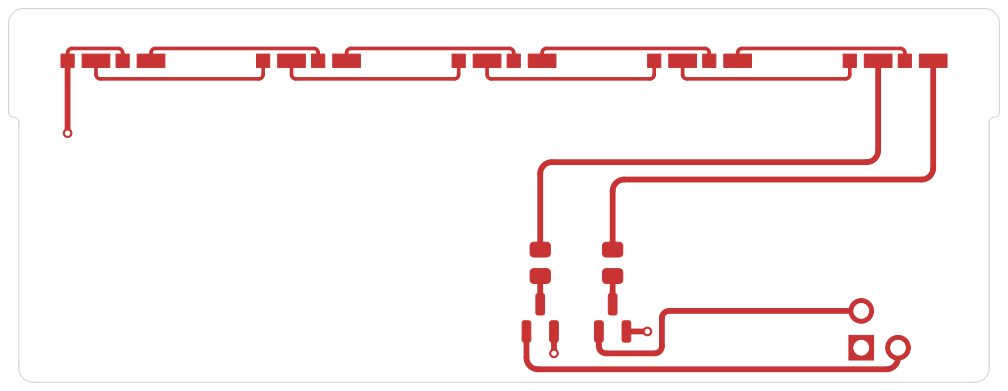
[picture p39: page 1]

Id: 1/9 Title: Silkscreen light attachment File: silkscreen-light-attachment.kicad_pcb Sheet:

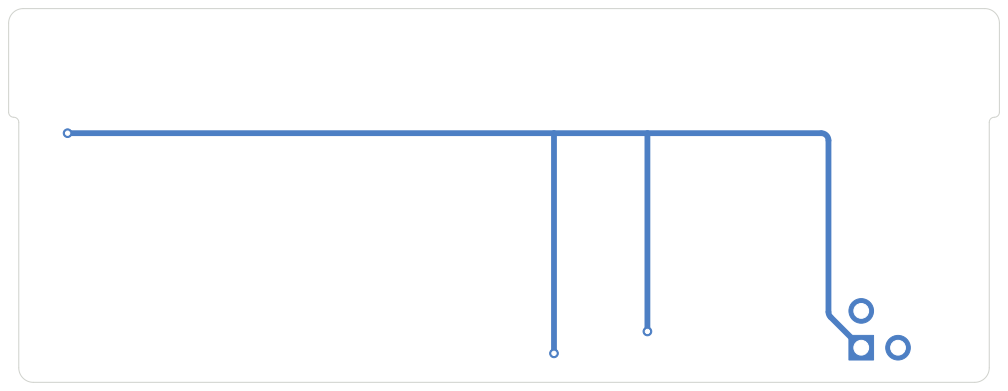
[picture p40: page 2]

Id: 2/9 Title: Silkscreen light attachment File: silkscreen-light-attachment.kicad_pcb Sheet:

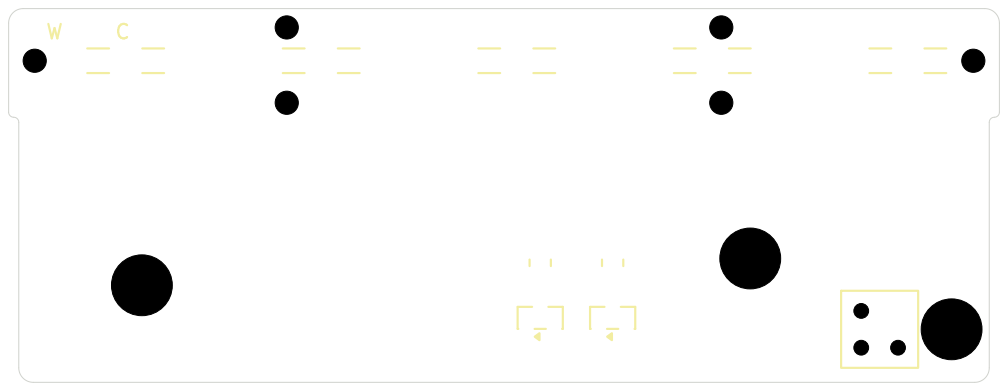
[picture p41: page 3]

Id: 3/9 Title: Silkscreen light attachment File: silkscreen-light-attachment.kicad_pcb Sheet:

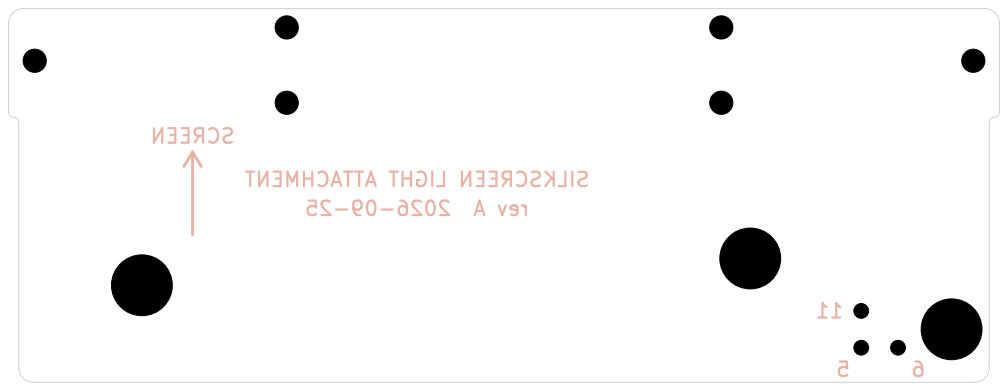
[picture p42: page 4]

Id: 4/9 Title: Silkscreen light attachment File: silkscreen-light-attachment.kicad_pcb Sheet:

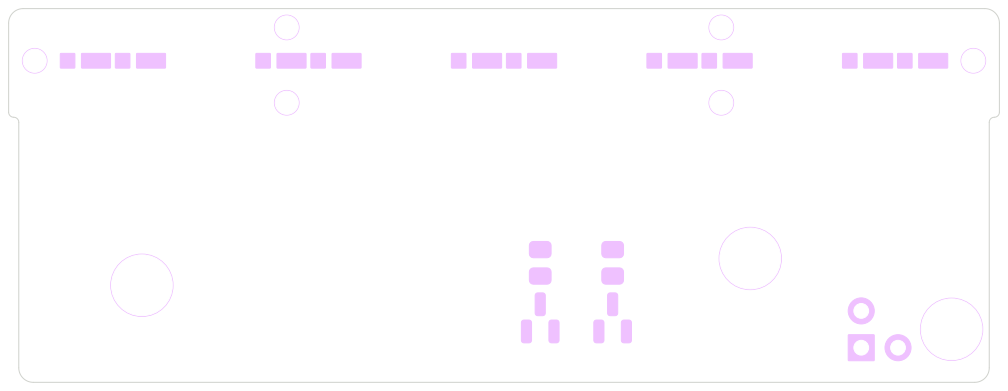
[picture p43: page 5]

Id: 5/9 Title: Silkscreen light attachment File: silkscreen-light-attachment.kicad_pcb Sheet:

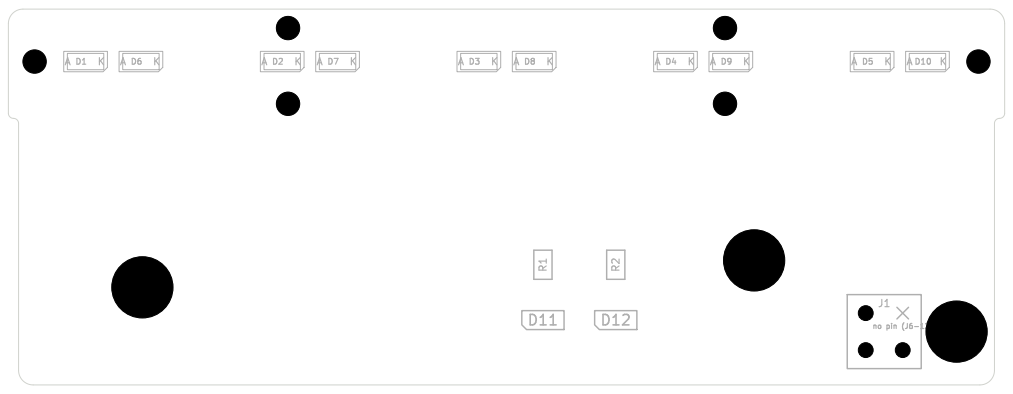
[picture p44: page 6]

Id: 6/9 Title: Silkscreen light attachment File: silkscreen-light-attachment.kicad_pcb Sheet:

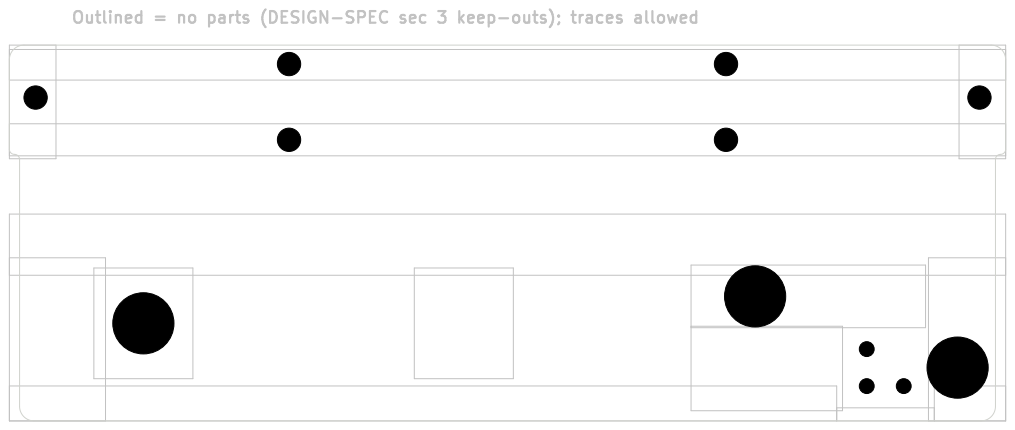
[picture p45: page 7]

Id: 7/9 Title: Silkscreen light attachment File: silkscreen-light-attachment.kicad_pcb Sheet:

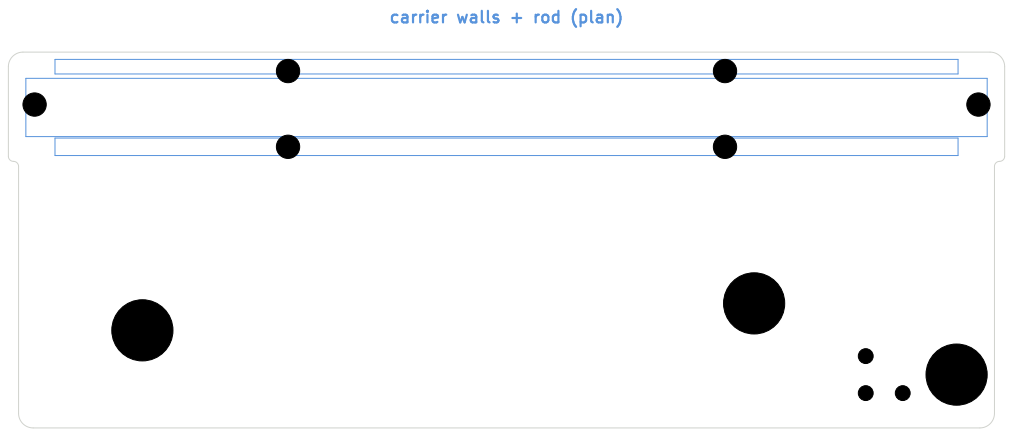
[picture p46: page 8]

Id: 8/9 Title: Silkscreen light attachment File: silkscreen-light-attachment.kicad_pcb Sheet:

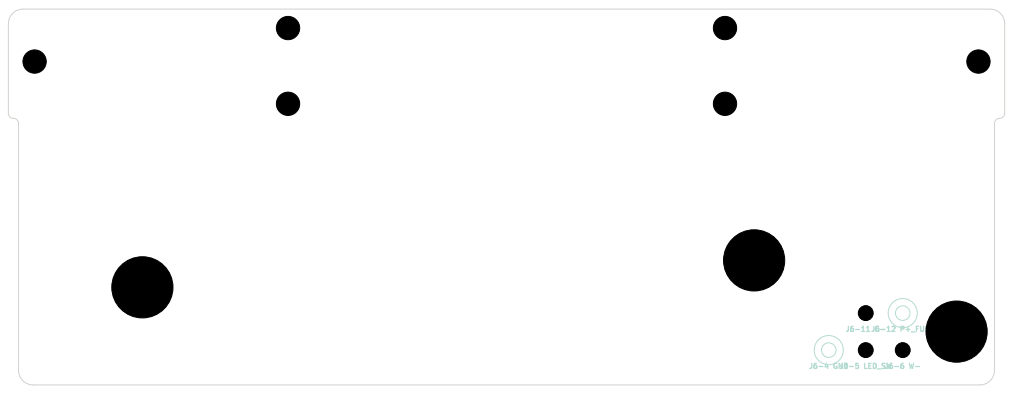
[picture p47: page 9]

Id: 9/9 Title: Silkscreen light attachment File: silkscreen-light-attachment.kicad_pcb Sheet:
