iandchasse/silkscreen-light-attachment/pcb/silkscreen-light-attachment.kicad_pcb

## KiCad design pcb/silkscreen-light-attachment.kicad_pcb (2026-10-21)

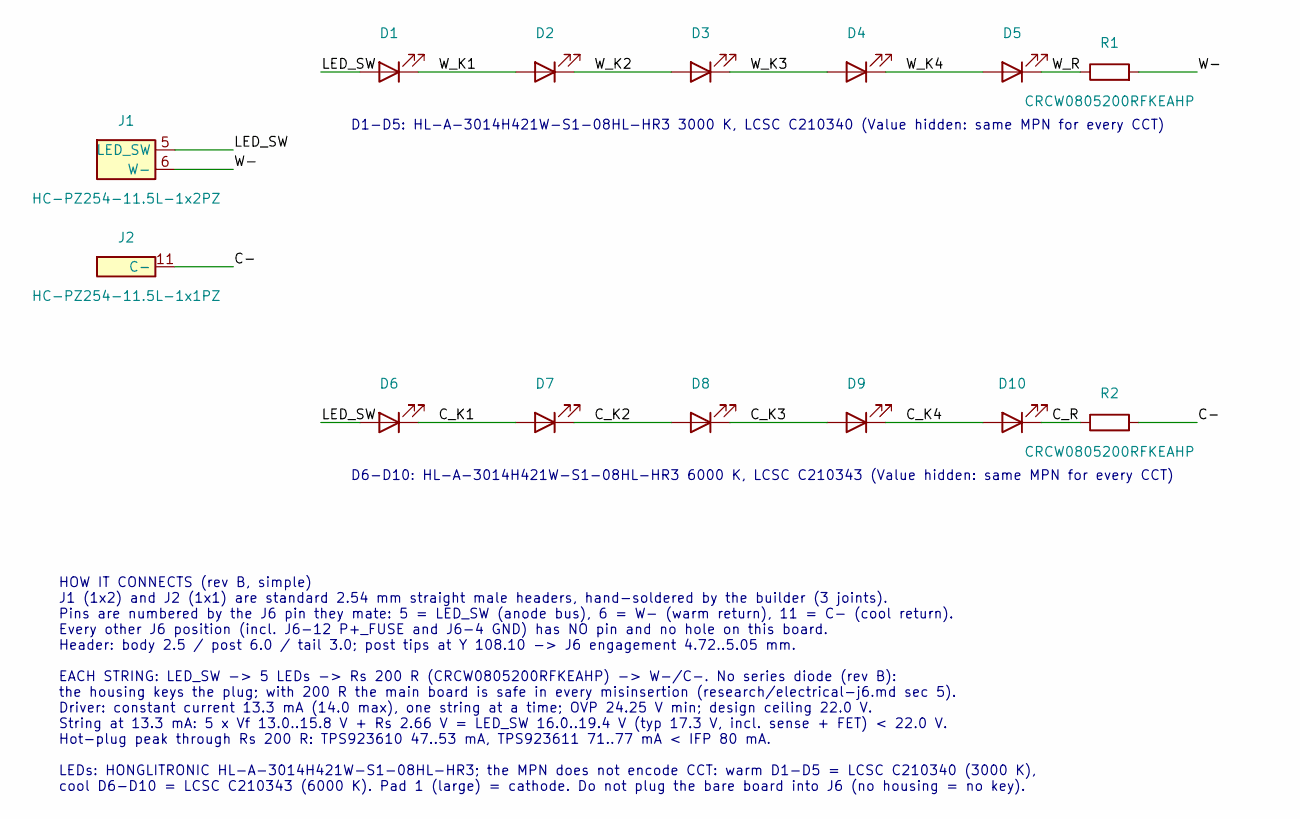
[picture p48: schematic silkscreen-light-attachment.kicad_sch, Silkscreen light attachment]

Parts:
D1, D2, D3, D4, D5, D6, D7, D8, D9, D10: HL-A-3014H421W-S1-08HL-HR3; LED_3014_HONGLI_HL-A-3014H421W; MPN HL-A-3014H421W-S1-08HL-HR3; DigiKey n/a - LCSC only (C210340 warm / C210343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
J1: HC-PZ254-11.5L-1x2PZ; J6_PLUG_1x2_P5_P6; MPN HC-PZ254-11.5L-1x2PZ; DigiKey Harwin M20-9990246 (DigiKey product 372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
J2: HC-PZ254-11.5L-1x1PZ; J6_PLUG_1x1_P11; MPN HC-PZ254-11.5L-1x1PZ; DigiKey 1 pin cut from Harwin M20-9990246 (Digi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
R1, R2: CRCW0805200RFKEAHP; R_0805_2012Metric; MPN CRCW0805200RFKEAHP; DigiKey 541-CRCW0805200RFKEAHPCT-ND

Connections:
/C-: J2.11, R2.2
/C_K1: D6.1 (K), D7.2 (A)
/C_K2: D7.1 (K), D8.2 (A)
/C_K3: D8.1 (K), D9.2 (A)
/C_K4: D9.1 (K), D10.2 (A)
/C_R: D10.1 (K), R2.1
/LED_SW: D1.2 (A), D6.2 (A), J1.5 (LED_SW)
/W-: J1.6 (W-), R1.2
/W_K1: D1.1 (K), D2.2 (A)
/W_K2: D2.1 (K), D3.2 (A)
/W_K3: D3.1 (K), D4.2 (A)
/W_K4: D4.1 (K), D5.2 (A)
/W_R: D5.1 (K), R1.1

Notes on the sheet:
D1-D5: HL-A-3014H421W-S1-08HL-HR3 3000 K, LCSC C210340 (Value hidden: same MPN for every CCT)
D6-D10: HL-A-3014H421W-S1-08HL-HR3 6000 K, LCSC C210343 (Value hidden: same MPN for every CCT)
HOW IT CONNECTS (rev B, simple) J1 (1x2) and J2 (1x1) are standard 2.54 mm straight male headers, hand-soldered by the builder (3 joints). Pins are numbered by the J6 pin they mate: 5 = LED_SW (anode bus), 6 = W- (warm return), 11 = C- (cool return). Every other J6 position (incl. J6-12 P+_FUSE and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

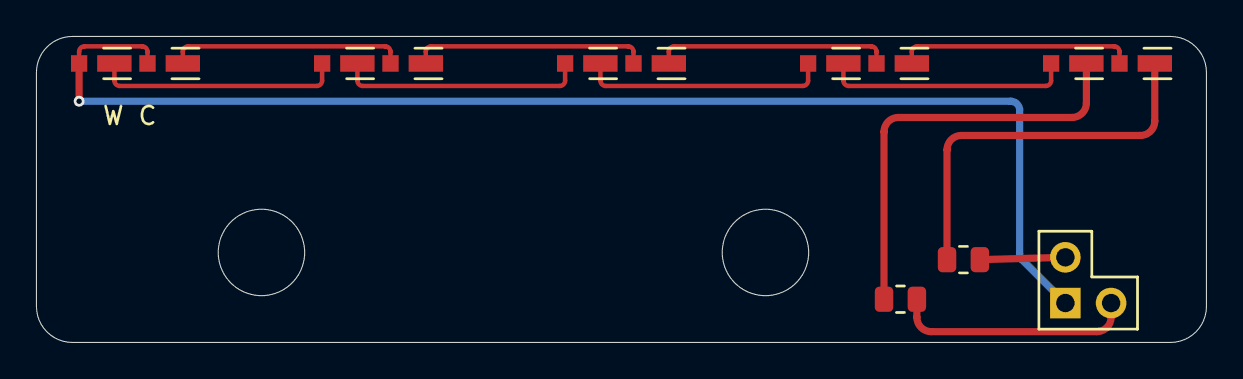
[picture p49: board silkscreen-light-attachment.kicad_pcb from above]

Board: 2 copper layers, 65.0 x 17.0 mm, 16 parts (0 on the bottom side), 13 nets.

Other parts of the board:
H1: M1 housing boss (dia 4.40) + ST2.2 screw; NPTH_4.80mm
H2: M2 housing boss (dia 4.40) + ST2.2 screw; NPTH_4.80mm
