iandchasse/silkscreen-light-attachment/(commit log)

2026-10-21 Silkscreen light attachment: rev B board (built, works), rev C housing (CAD-checked), docs and fab files
    [base.step, base.stl, bom.csv, carrier.step, carrier.stl, clip.step, clip.stl, cover.step]
2026-10-21 NOTICE: list the copied KiCad R_0805 3D model as third-party
2026-10-21 README: AI-generated design notice, with a link to Silkscreen's AI disclosure
2026-10-22 Docs: name main-board parts in plain words, keep designators as labels
    Reader-facing text (README, NOTICE, assembly, ordering, safety guides) now names the frontlight connector, expansion header, power button and similar parts in plain words and gives the board designator only as a label. Technical docs introduce each designator with its plain name once. File names, code identifiers and generated files are unchanged.
2026-10-22 Docs: say 'expansion header' for the main board's header, fill legend gaps, status lines agree with the README
