iandchasse/silkscreen-light-attachment/(notices)

Notices in the files:
pcb/silkscreen-light-attachment.kicad_pcb:
Licensed under CERN-OHL-S-2.0
(c) 2026 idc LLC
